chuangye-gu/graduation_project/pcb设计学习/工程/正.PNG

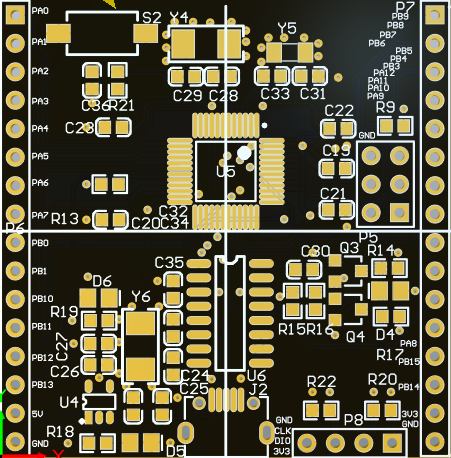
pcb设计学习/工程/正.PNG
