chuangye-gu/graduation_project/pcb设计学习/渲染PCB文件/渲染PCB文件/stm32正面.648.png

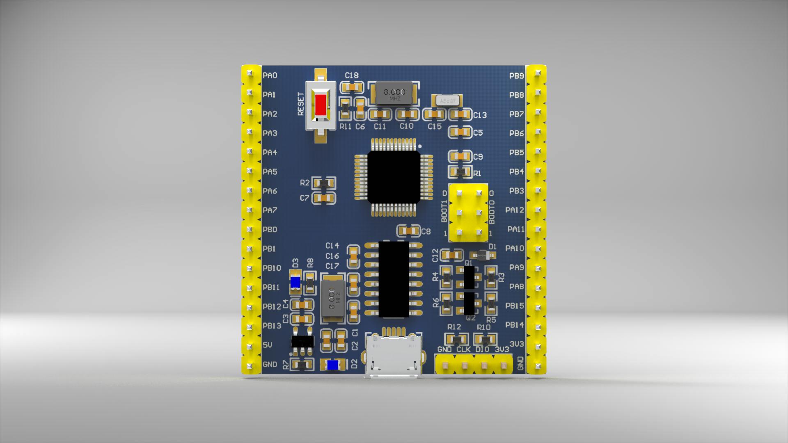
pcb设计学习/渲染PCB文件/渲染PCB文件/stm32正面.648.png
