chuangye-gu/graduation_project/pcb设计学习/元件库/元件库/AltiumDesignerIntlib-master/README.md

###知创学院[zicreate.com]原创Altium Designer集成库，我们会不断的整理完善更多的器件###
####下载地址：####
>**官网:**[http://zicreate.com/c/5640473a1aeee345906f5fa3][2]     [资料下载]
>**Github:**[https://github.com/zicreate/AltiumDesignerIntlib][1]
> 
  [1]: https://github.com/zicreate/AltiumDesignerIntlib
  [2]: http://zicreate.com/c/5640473a1aeee345906f5fa3
如果您在使用过程中发现有错误的地方，请及时告知我们，我们会及时勘误更新。
*本集成库由 zicreate.com jason 创作，采用知识共享署名3.0中国大陆许可协议进行许可。*

###Altium Designer Intlib V0.0.3###
####4.Digital IC####
```
     |---DAC8541              增加DAC8541DAC芯片
```
####2.Components####
```
     |---SIP3                 增加SIP3插座
```

###Altium Designer Intlib V0.0.2###
####1.Analog IC####
```
     |---L7805               增加贴片封装SOT-89-3
```
####4.Digital IC####
```
     |---MAX812              增加max812复位管理芯片
```

###Altium Designer Intlib V0.0.1###

####1.Analog IC####
```
    |---ADA4700-1           Operational Amplifier
    |---AMC1200
    |---AMS1117-3.3         3.3V  3-Terminal Adjustable Positive Voltage Regulator
    |---ATT7022
    |---DAC8551             DAC8551
    |---DAC8562
    |---L7805               3-Terminal Adjustable Positive Voltage Regulator
    |---LM2576
    |---MIC29302
    |---REF5025
    |---TPS63001            dc-dc
```
####2.Components####
```
    |---6N136               6N136
    |---BAT                 Multicell Battery
    |---BELL                Electrical Bell
    |---BRIDGE              Diode Bridge
    |---CAP1                Capacitor
    |---CAP2                Electrolytic Capacitor
    |---DIGITRON1*1         
    |---DIGITRON2*1
    |---DIGITRON3*1         
    |---DIGITRON4*1         
    |---DIODE               Diode
    |---DIODE1              Schottky Diode
    |---DSP2A               DSP2A
    |---FUSE-R              
    |---L                   Inductor
    |---LCD12864            
    |---LCD1602
    |---LED1                Typical RED GaAs LED
    |---LED2                LED,Two Colour,Common anode,Three Pin
    |---LED3                LED,Two Colour,Four Pin
    |---NMOS1               N-Channel Power MOSFET
    |---NMOS2               N-Channel Power MOSFET
    |---NPN                 NPN Transistor
    |---OPTOISO1            Optoisolator
    |---PNP                 PNP Transistor
    |---RELAYS              Single-Pole Dual-Throw Relay
    |---RELAYS1
    |---RES                 Resistance
    |---RES-P4
    |---RES-V
    |---Res Varistor        Varistor (Voltage-Sensitive Resistor)
    |---SW                  Switch
    |---SW-4                
    |---SW-8
    |---SW_CODED            Rotary Coded Switch
    |---TQ2                 
    |---TVS                 TVS
    |---TVS2                TVS
    |---XTAL                Crystal Oscillator
    |---XTAL_PW
    |---XTAL_PWR
    |---ZENER               Zener Diode
```
####3.Connectors####
```
   |---CON10
   |---CON13
   |---CON2
   |---CON3
   |---CON4
   |---CON5
   |---CON6
   |---CON8                
   |---DB9RA
   |---DIN64
   |---DIN96               
   |---HARTING-F-48        HARTING-F-48
   |---HR911105A
   |---HR911105A_1         
   |---Header10X2          Header10X2
   |---Header15X2          Header15X2
   |---Header3X2           Header3X2
   |---Header5X2           Header5X2
   |---Header8X2           Header10X2
   |---MINIUSB             
   |---PWR2.5              Low Voltage Power Supply Connector
   |---RJ45                
   |---TP
```
####4.Digital IC####
```
   |---74HC14              74HC14
   |---74HC573             74HC573
   |---AT24C16
   |---AT45DB041D          Flash IC
   |---BL55076             
   |---CAN                 CAN 5V
   |---DAC2904             DAC2904
   |---DM9161AE            Ethernet PHY
   |---DP83848I            Ethernet PHY
   |---DS1302N             Trickle Charge Timekeeping Chip
   |---DS2460
   |---FRAM                FRAM FM25L64
   |---PCF8575             PCF8575
   |---PCF8583             RTC
   |---RS232               RS232 IC 3.3V
   |---RS485               RS485 IC 3.3V
   |---TPS3823-33
   |---ULN2003A
   |---ULN2803A
```
####5.Microcontrollers####
```
   |---LPC1758FBD80        ARM Cortex M3,LQFP80 Footprint
   |---LPC1768FBD100       ARM Cortex M3,LQFP100 Footprint
   |---LPC2138FBD64
   |---LPC2468
   |---STC12C5A32S2
   |---STC89C52RC          80C51 8-Bit Flash Microcontroller Family, 8 kB Flash
   |---STM32F103ZET6
```
####6.Module####
```
   |---B0505LS             
   |---CTM1050T
   |---EMW3162             EMW3162
   |---LPC1768-M           LPC1758 Module
   |---ZY_WHAD-10W
```
