chuangye-gu/graduation_project/毕业答辩PPT模版.pptx

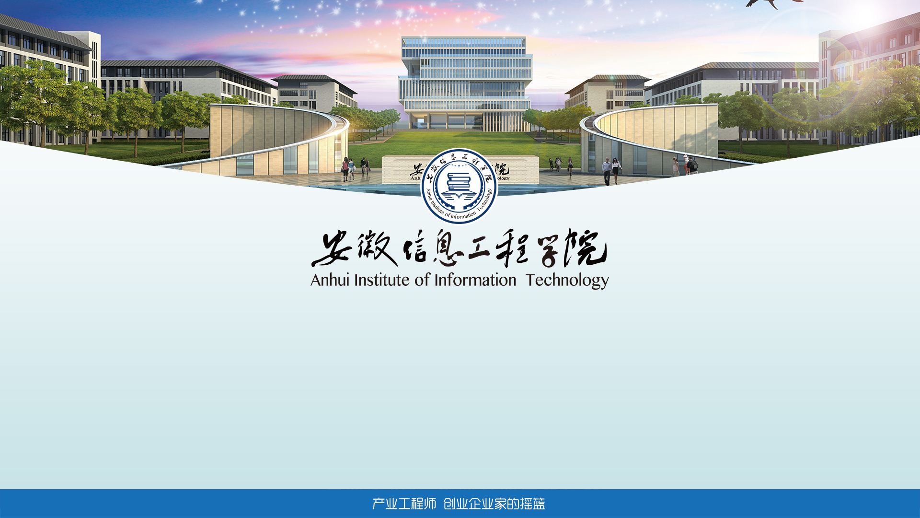
[picture p3: figure]

论文题目

汇报人：***
日期：2020年5月24日

## Slide 2

目 录

Part 1

研究背景、意义及目标

研究内容及设计方案

Part 2

Part 2

研究结果、总结

## Slide 3

研究背景、意义及目标

该部分简单介绍，一带而过。

## Slide 4

研究内容及设计方案

详细介绍设计方案。

## Slide 5

研究结果、总结

研究结果（做出实物的写实物调试结果，没有实物的同学写仿真结果）、不足之处。

## Slide 6
