chuangye-gu/graduation_project/归档打印/3.1-彩色打印修改.pdf

谷创业：恒温烤箱系统的设计

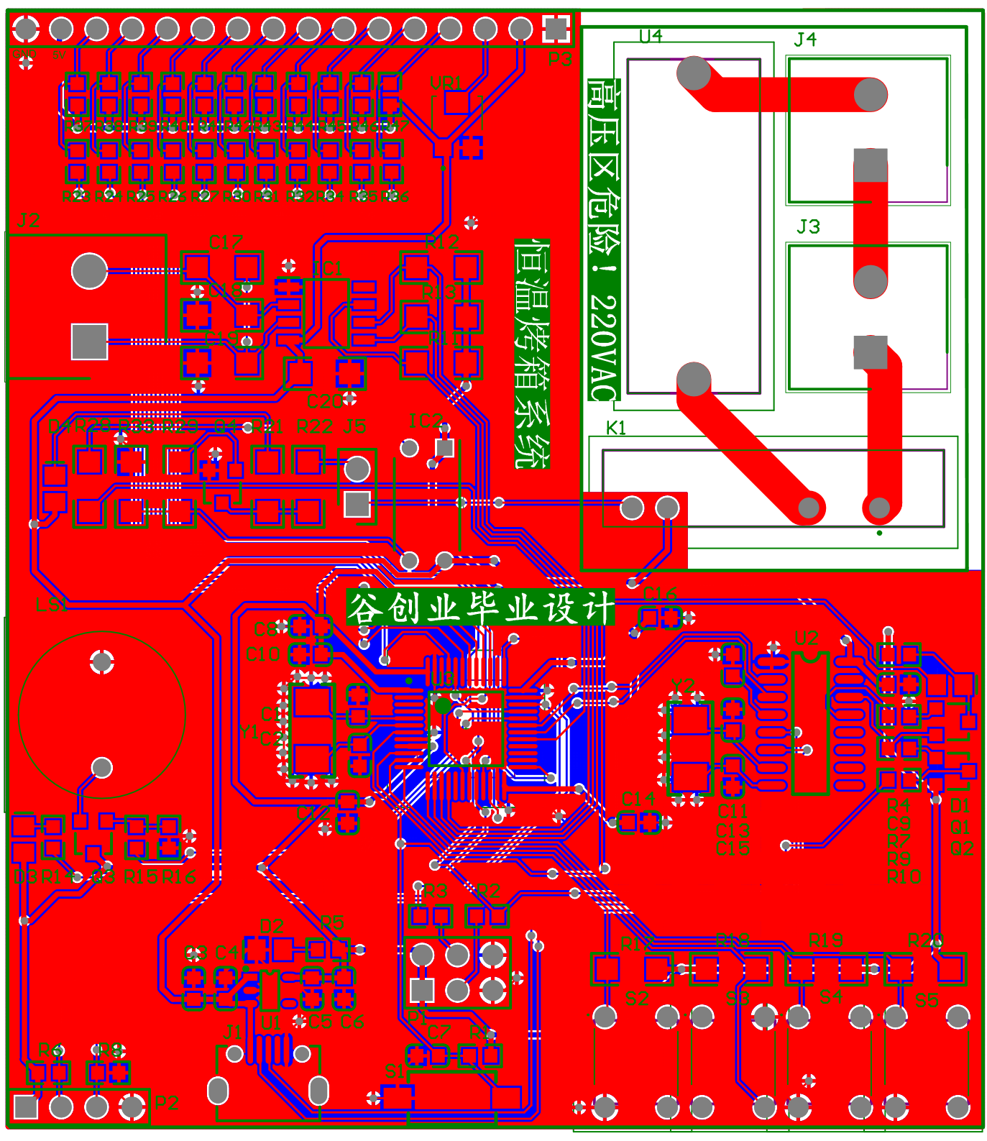
[picture p4: figure]

- 38 -

## 附录 B PCB
