chuangye-gu/graduation_project/归档文件/谷创业-档案袋封面.docx

2020届本科毕业设计（论文）

题目 | | 恒温烤箱系统的设计
学生姓名 | | 谷创业 | | | 学号 | | 316207010104
学院 | | 电气与电子工程学院 | | | 专业班级 | | 自动化1601班
指导教师 | | 张松林 | | | 完成日期 | | 2020年05月26日

装袋材料清单（按照序号从上到下装袋）
序号 | 材料名称 | | 数量 | 序号 | | 材料名称 | | 数量
1 | 诚信承诺书 | | 1份 | 6 | | 指导记录 | | 1份
2 | 成绩评定表 | | 1份 | 7 | | 中期检查表 | | 1份
3 | 论文定稿 | | 1份 | 8 | | 答辩记录表 | | 1份
4 | 任务书 | | 1份 | 9 | | 相似性检测报告 | | 1份
5 | 开题报告 | | 1份 | 10 | | 图纸及其他 | | 1份

教务处 制
