chuangye-gu/graduation_project/归档文件/word/1-谷创业-诚信承诺书.docx

本科毕业设计（论文）诚信承诺书

1.本人郑重地承诺所呈交的毕业设计（论文），是在指导教师的指导下严格按照学校和学院有关规定完成的。

2.本人在毕业设计（论文）中引用他人的观点和参考的资料均加以了注释和说明。

3.本人承诺在毕业设计（论文）选题和研究内容过程中没有抄袭他人研究成果和伪造相关数据等行为。

4.本人在毕业设计（论文）中对侵犯任何方面知识产权的行为，将由本人承担一切相应的法律责任。

作者签名： 谷创业

2019年11月4日
