chuangye-gu/graduation_project/1602/1.PNG

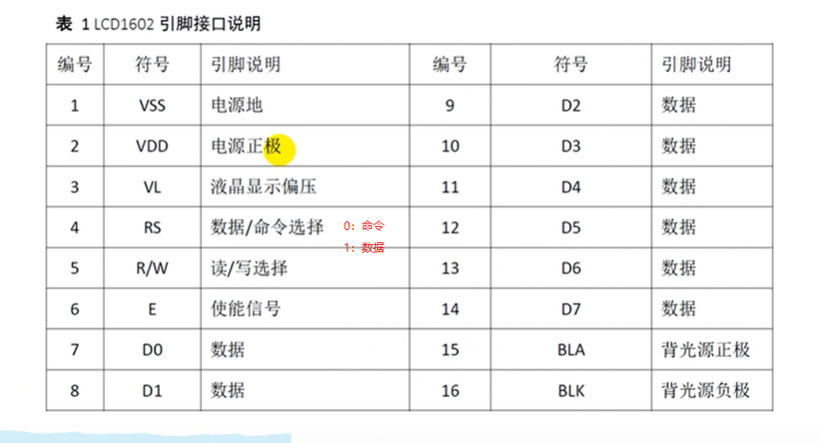
1602/1.PNG
