chuangye-gu/graduation_project/1602/2.PNG

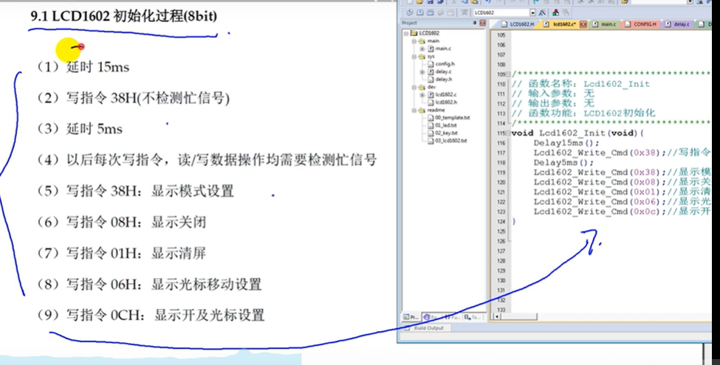
1602/2.PNG
