chuangye-gu/graduation_project/1602/3.PNG

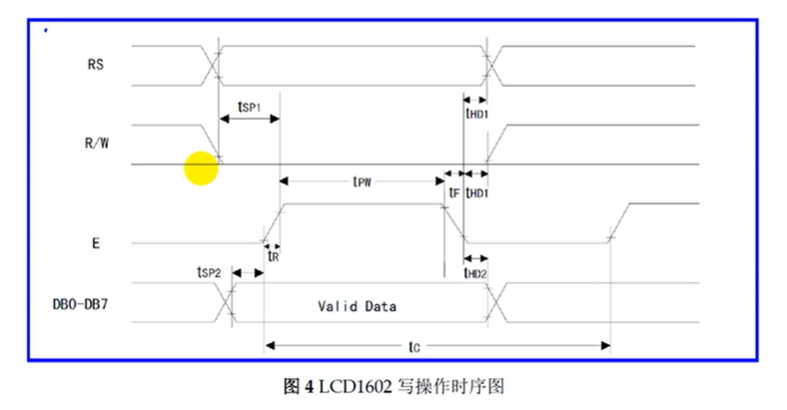
1602/3.PNG
