chuangye-gu/graduation_project/1602/4.PNG

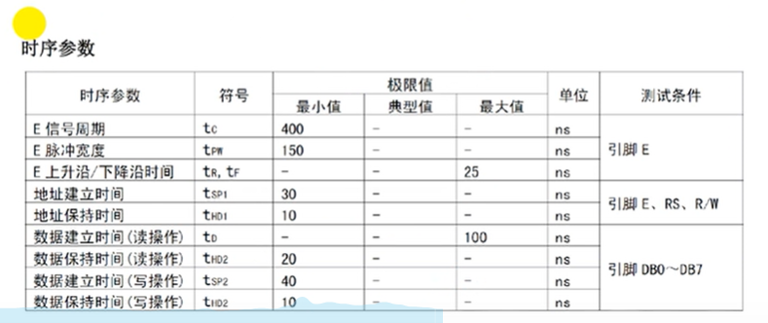
1602/4.PNG
