chuangye-gu/graduation_project/PCB/yunqijian/1.PNG

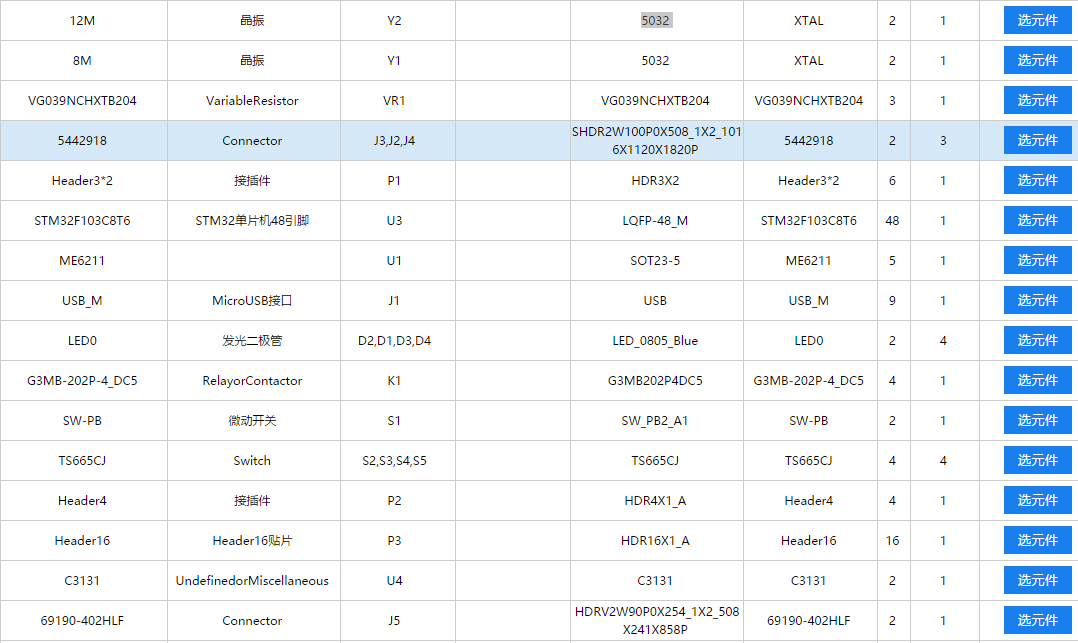
PCB/yunqijian/1.PNG
