chuangye-gu/graduation_project/PCB/恒温烤箱控制系统/正面.PNG

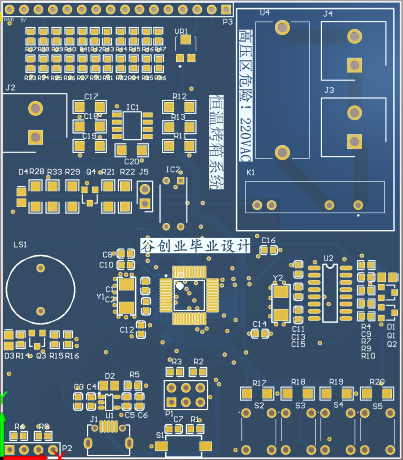
PCB/恒温烤箱控制系统/正面.PNG
