chuangye-gu/graduation_project/pcb设计学习/工程/反.PNG

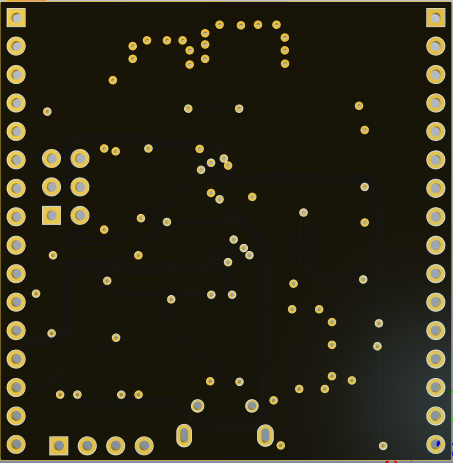
pcb设计学习/工程/反.PNG
