chuangye-gu/graduation_project/pcb设计学习/渲染PCB文件/渲染PCB文件/1WY$}5K@$B`TE4E2D@VDA6P.png

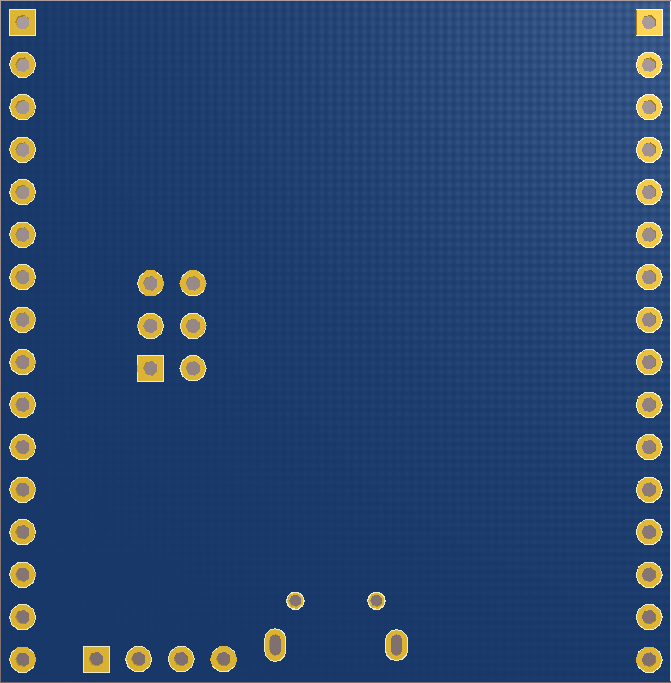
pcb设计学习/渲染PCB文件/渲染PCB文件/1WY$}5K@$B`TE4E2D@VDA6P.png
