chuangye-gu/graduation_project/pcb设计学习/渲染PCB文件/渲染PCB文件/4JOJ[C2_WN(F_FNJ7RSONUU.png

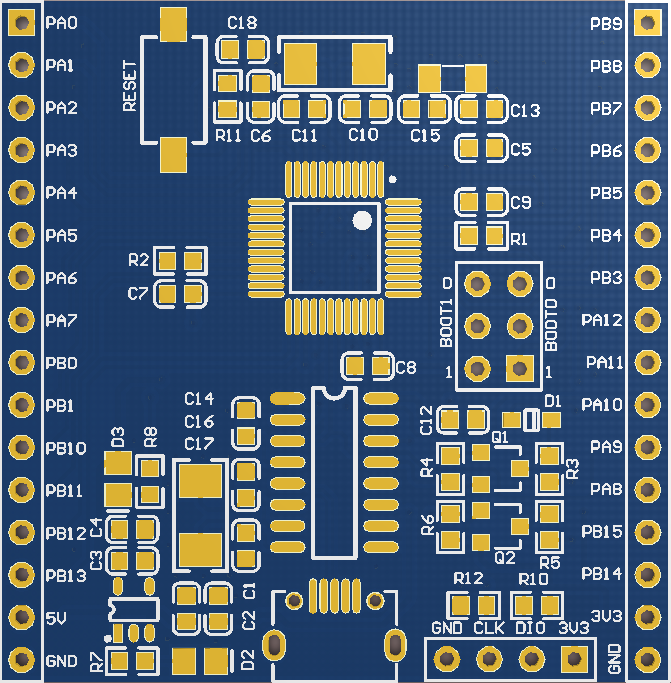
pcb设计学习/渲染PCB文件/渲染PCB文件/4JOJ[C2_WN(F_FNJ7RSONUU.png
