chuangye-gu/graduation_project/图片/1-1Q22920215I55.png

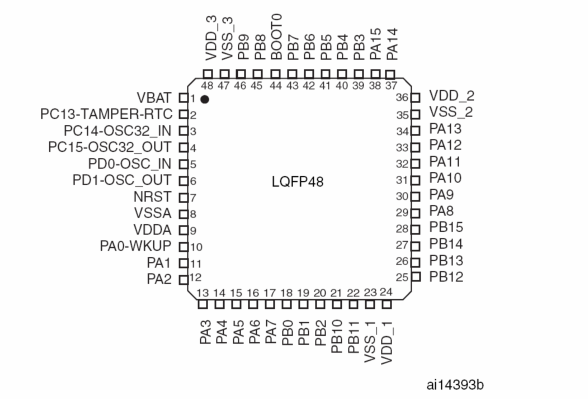
图片/1-1Q22920215I55.png
