chuangye-gu/graduation_project/图片/50摄氏度.png

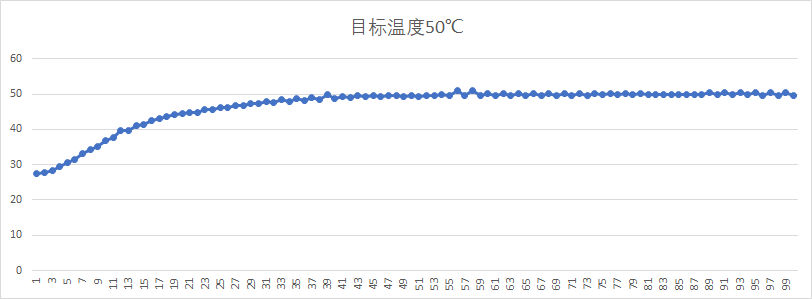
图片/50摄氏度.png
