chuangye-gu/graduation_project/图片/70摄氏度.png

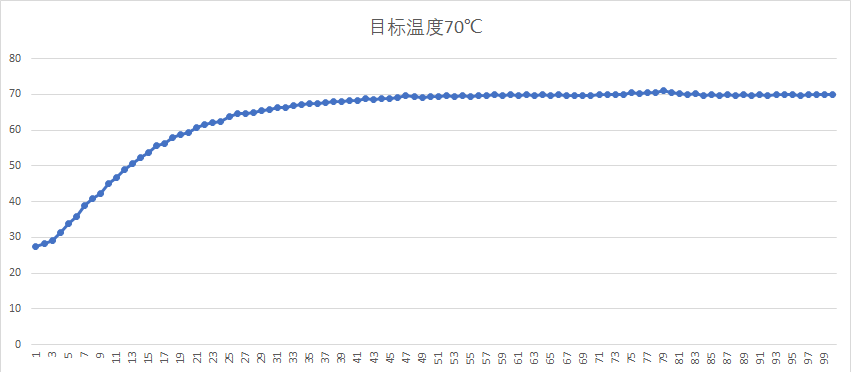
图片/70摄氏度.png
