chuangye-gu/graduation_project/图片/boot.PNG

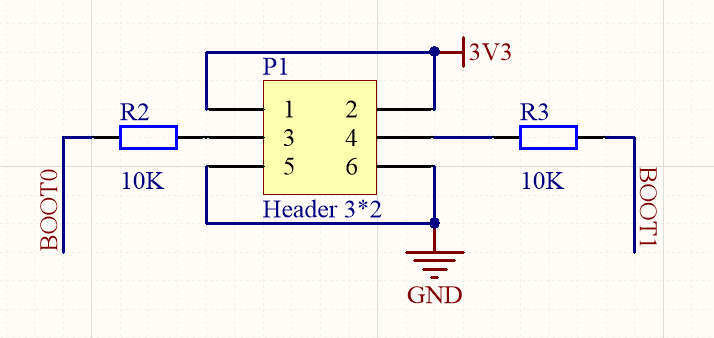
图片/boot.PNG
