chuangye-gu/graduation_project/图片/c8t6引脚.png

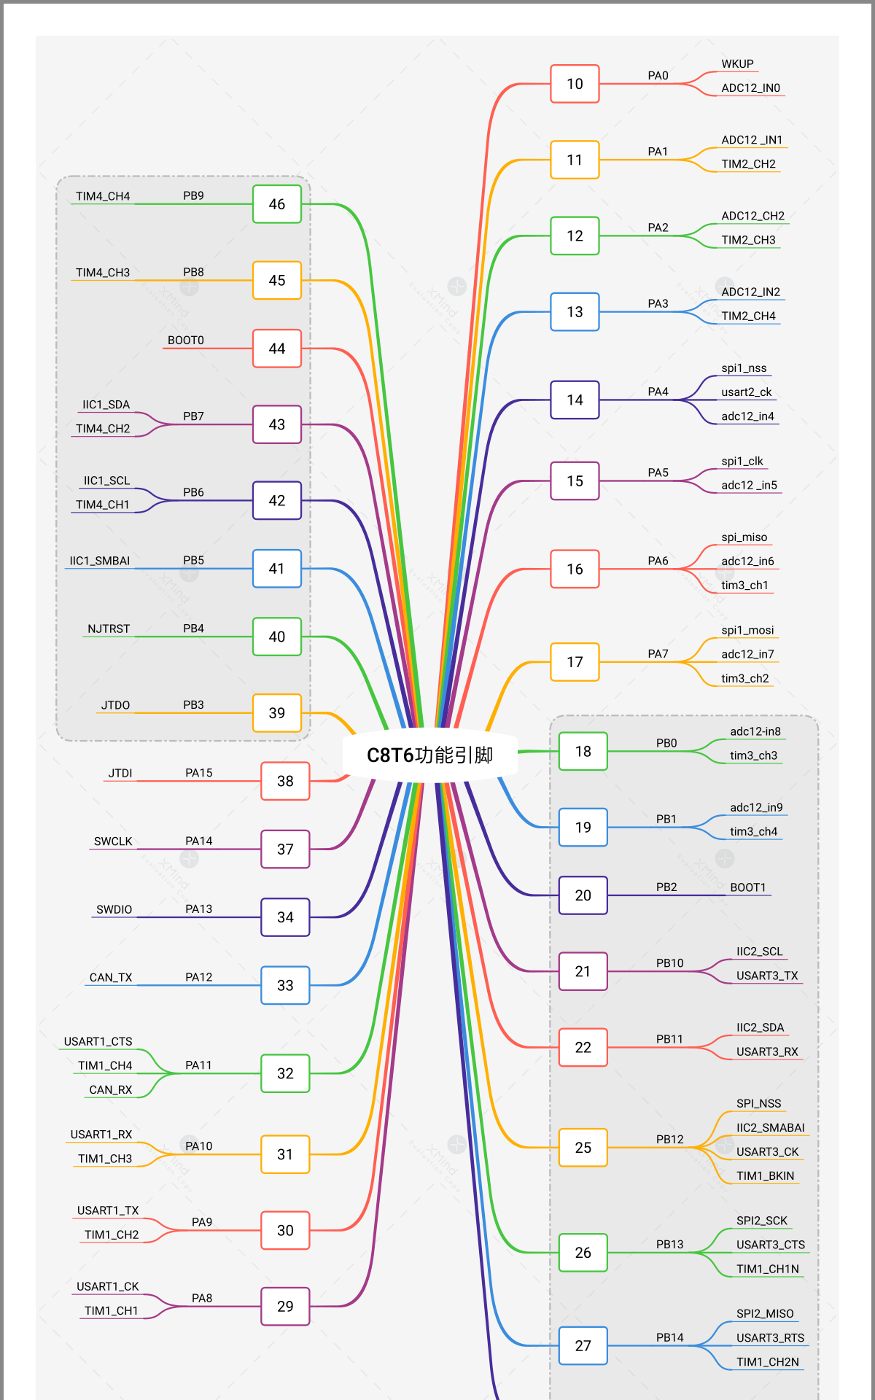
图片/c8t6引脚.png
