chuangye-gu/graduation_project/图片/CH340.PNG

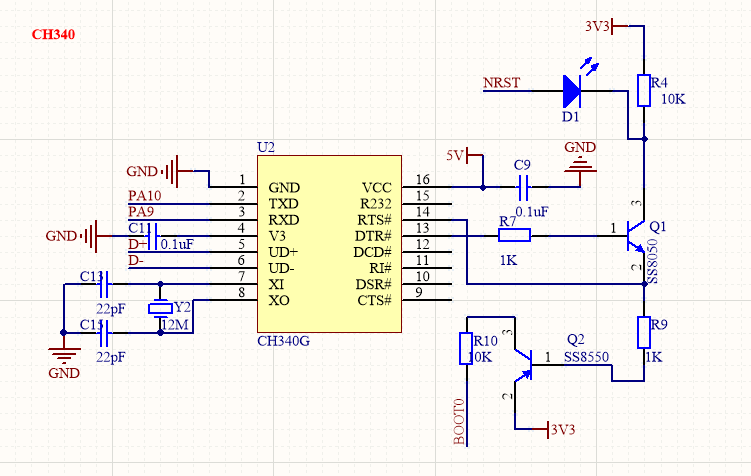
图片/CH340.PNG
