chuangye-gu/graduation_project/图片/lcd.PNG

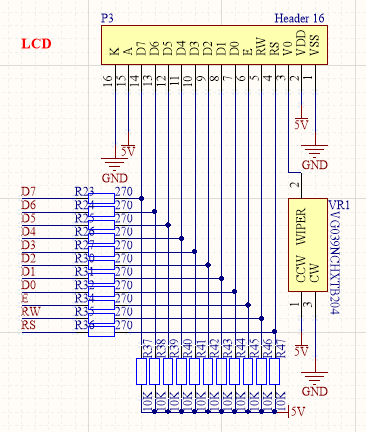
图片/lcd.PNG
