chuangye-gu/graduation_project/图片/MAX6675时序图.PNG

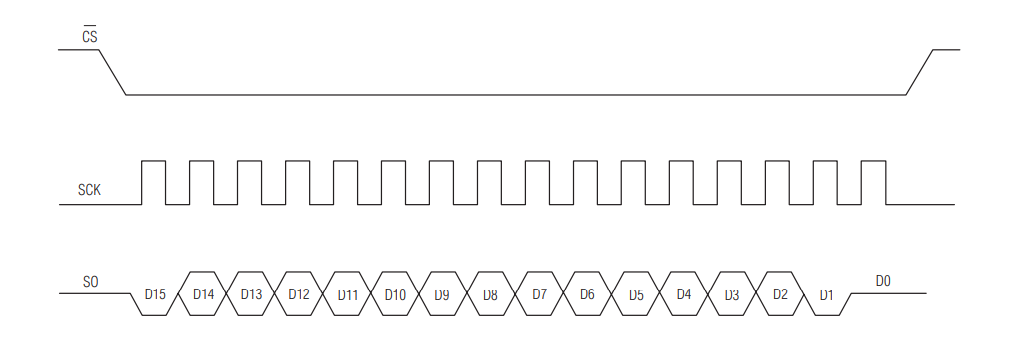
图片/MAX6675时序图.PNG
