chuangye-gu/graduation_project/图片/PID控制算法流程图.png

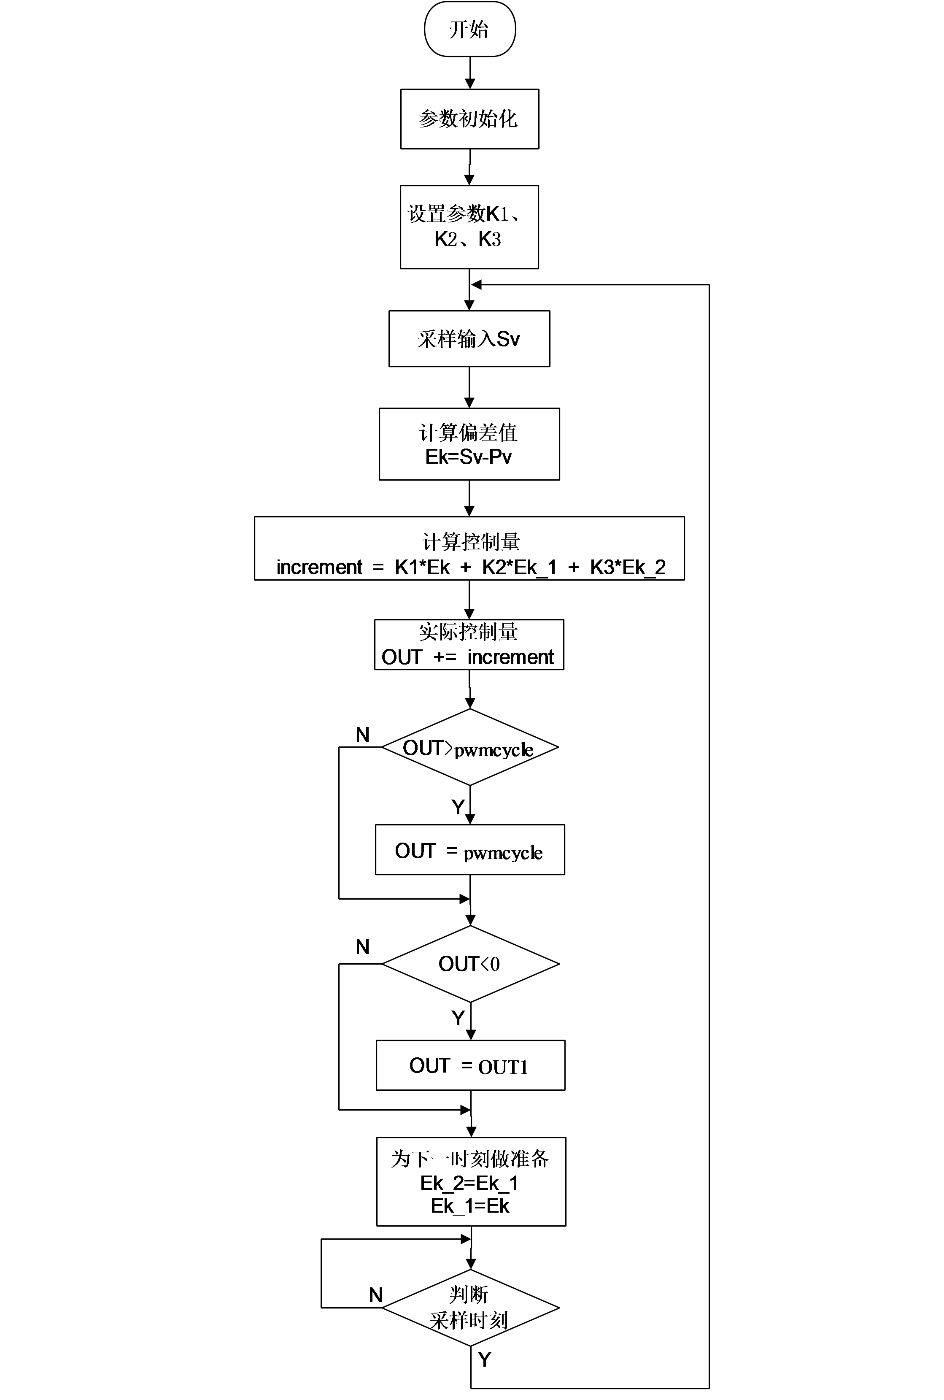
图片/PID控制算法流程图.png
