chuangye-gu/graduation_project/图片/下载.PNG

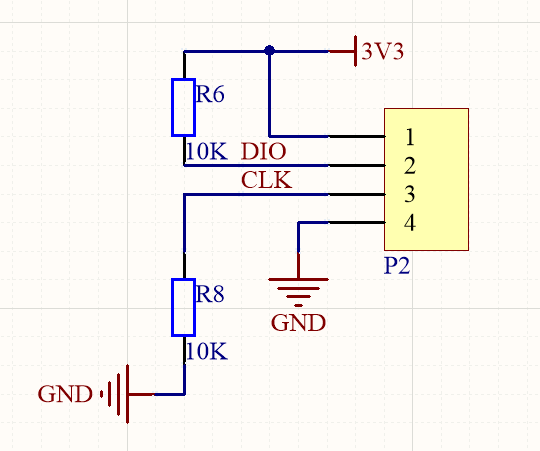
图片/下载.PNG
