chuangye-gu/graduation_project/图片/主程序.jpg

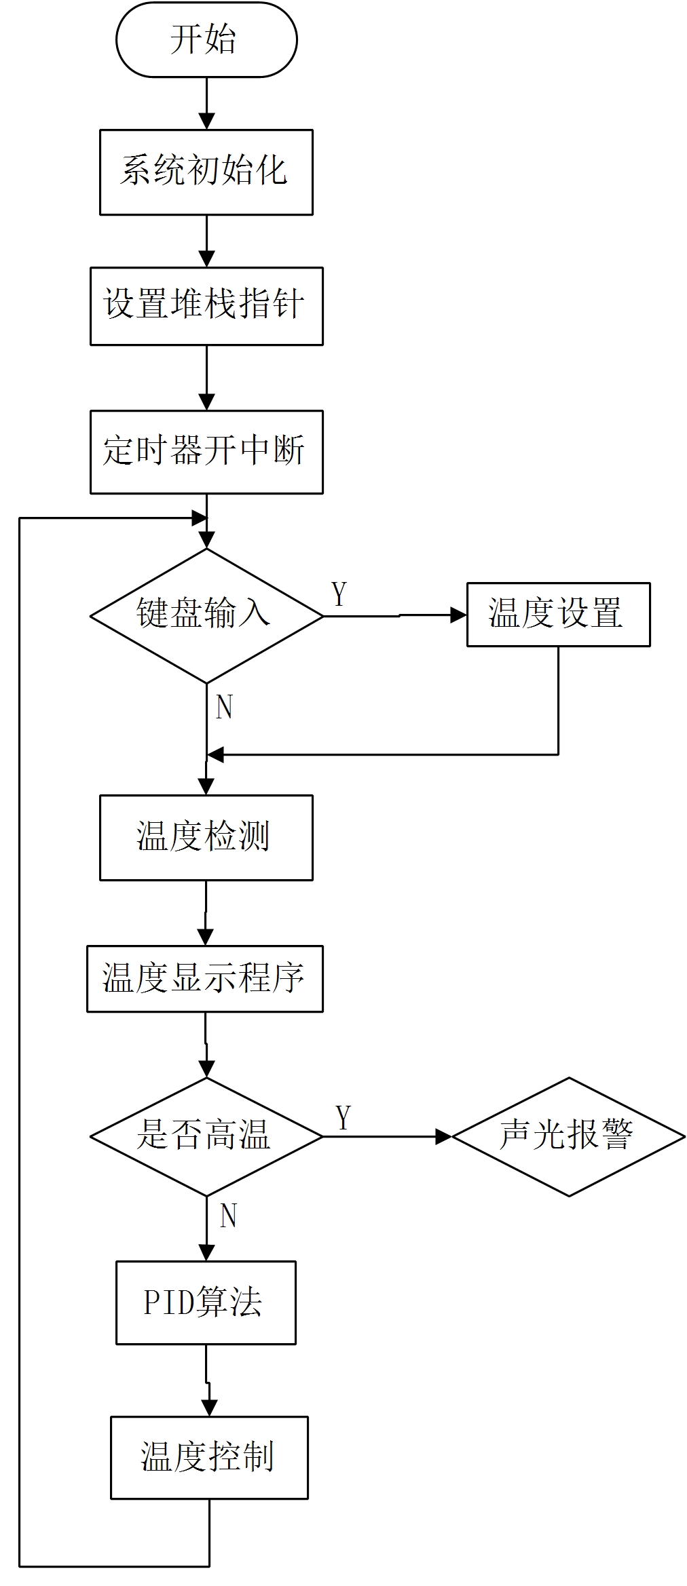
图片/主程序.jpg
