chuangye-gu/graduation_project/图片/主程序.png

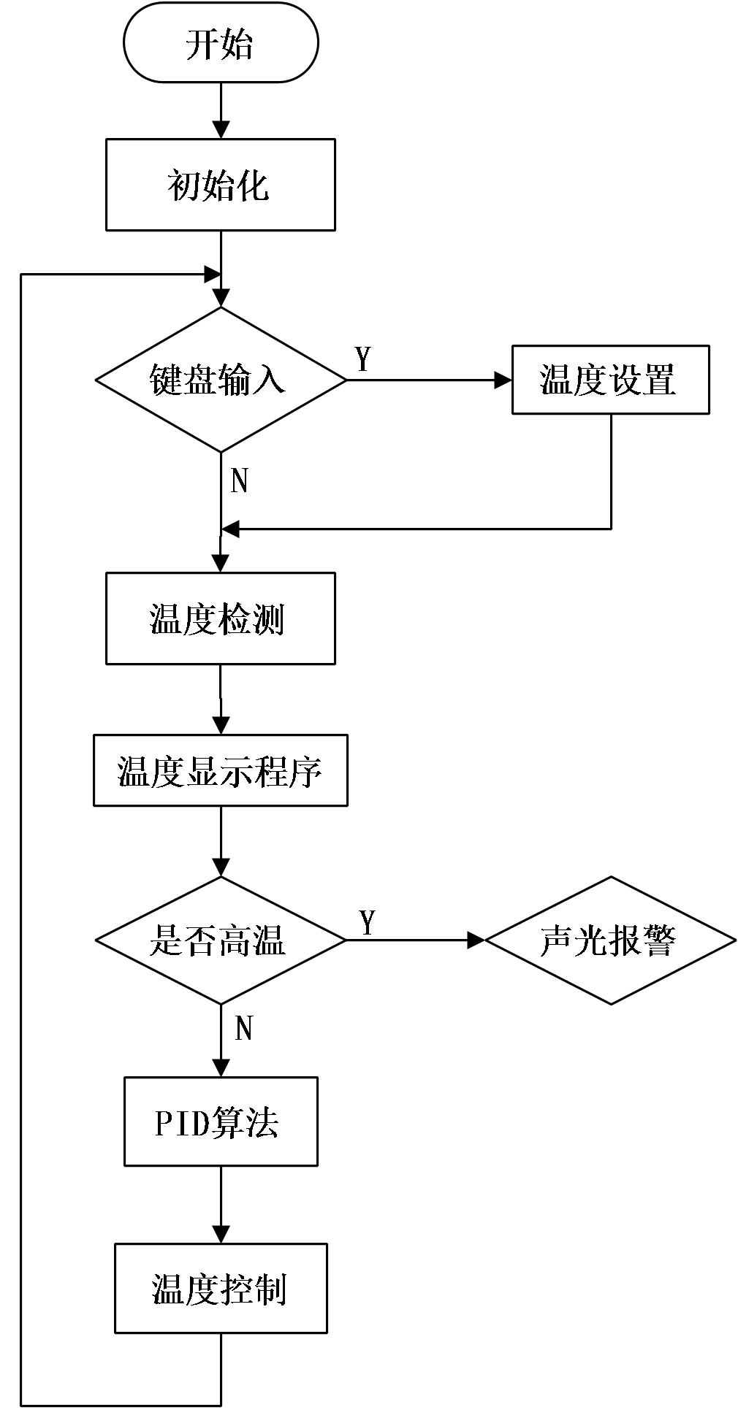
图片/主程序.png
