chuangye-gu/graduation_project/图片/仿真主图.PNG

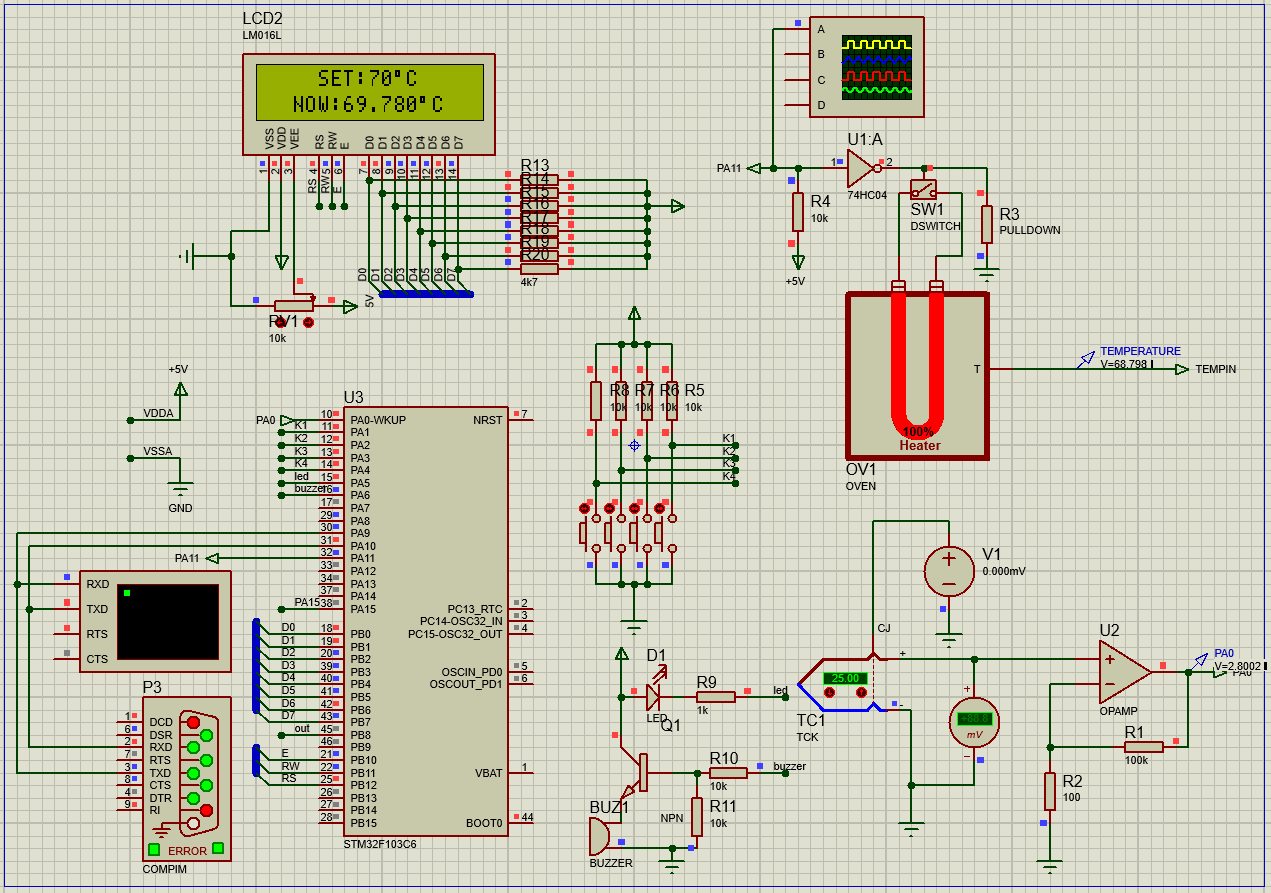
图片/仿真主图.PNG
