chuangye-gu/graduation_project/图片/仿真副图.PNG

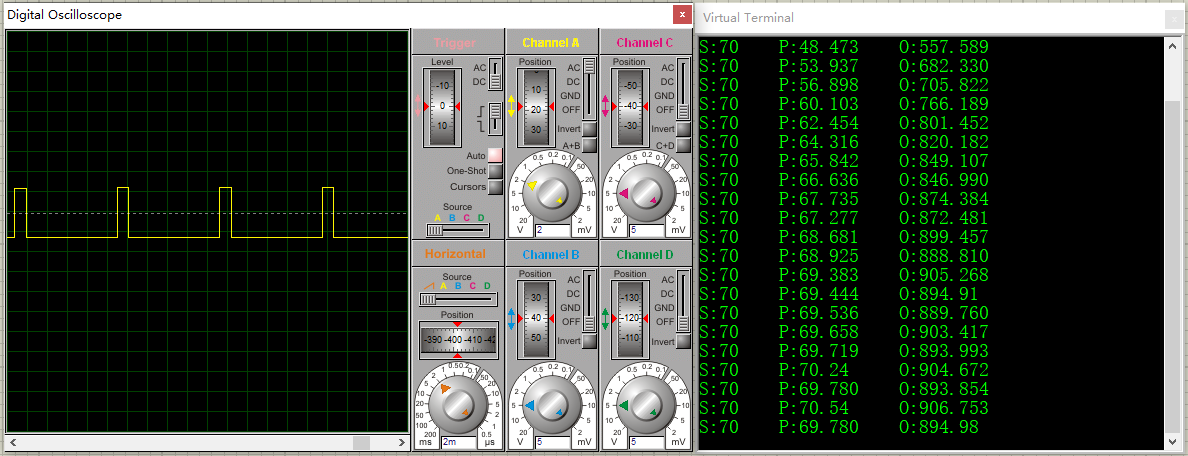
图片/仿真副图.PNG
