chuangye-gu/graduation_project/图片/仿真图.png

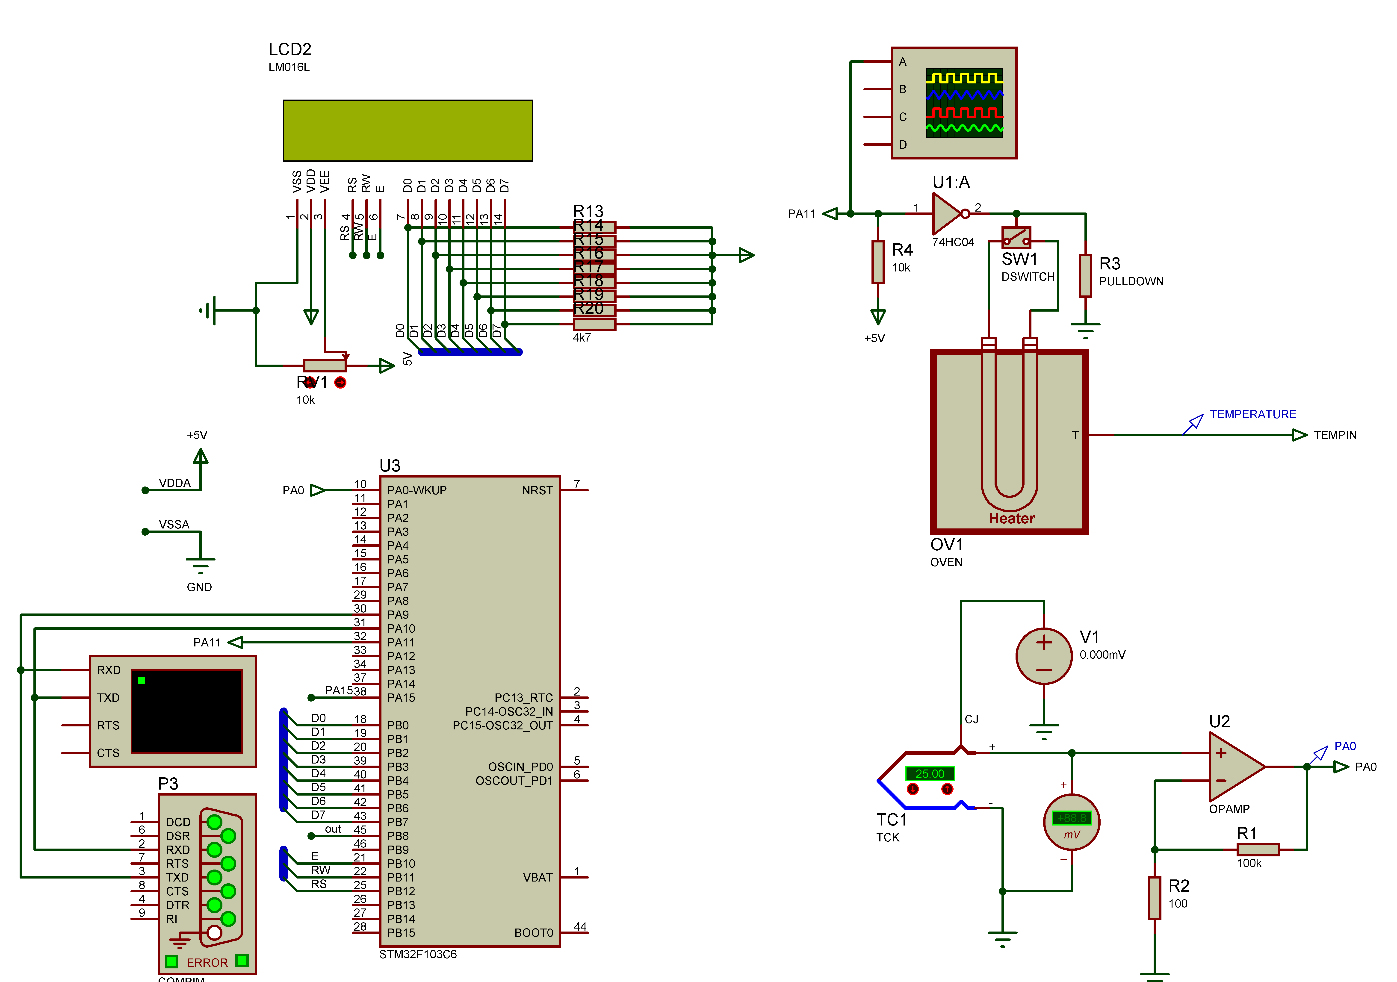
图片/仿真图.png
