chuangye-gu/graduation_project/图片/仿真部分文字.PNG

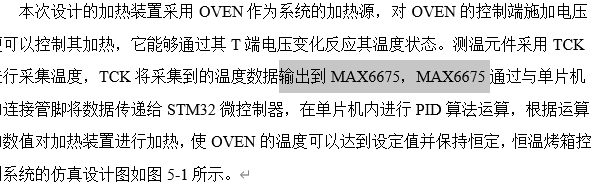
图片/仿真部分文字.PNG
