chuangye-gu/graduation_project/图片/报警.PNG

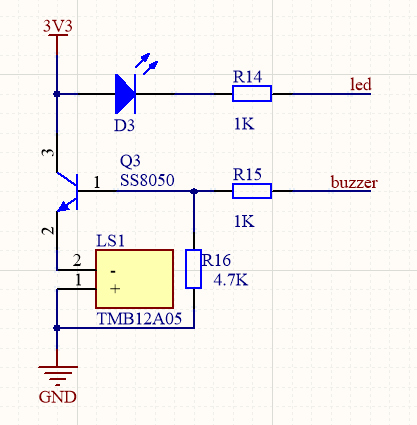
图片/报警.PNG
