chuangye-gu/graduation_project/图片/控制电路.PNG

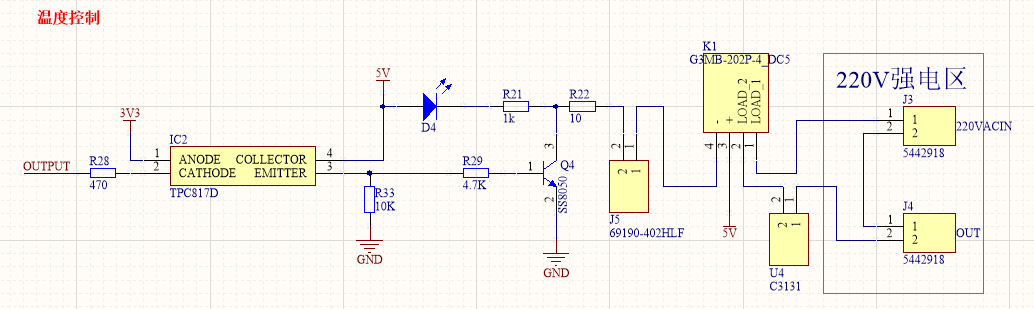
图片/控制电路.PNG
