chuangye-gu/graduation_project/图片/显示程序.png

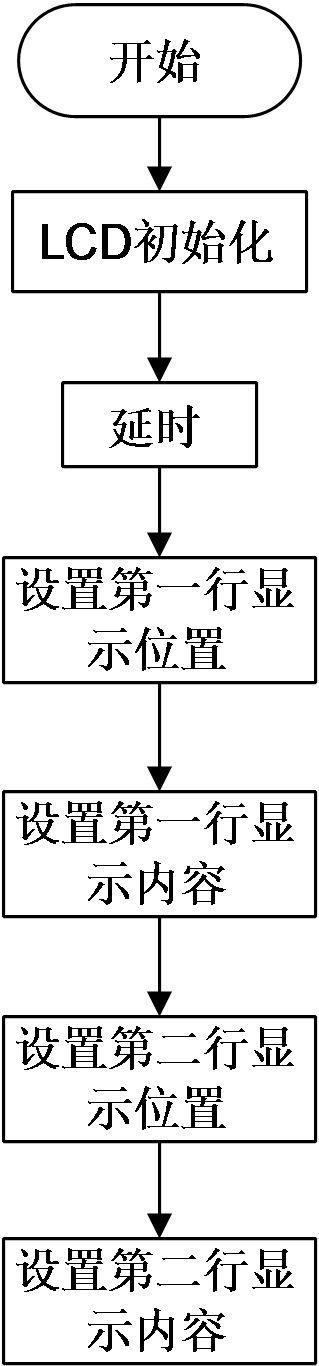
图片/显示程序.png
