chuangye-gu/graduation_project/图片/温度控制.png

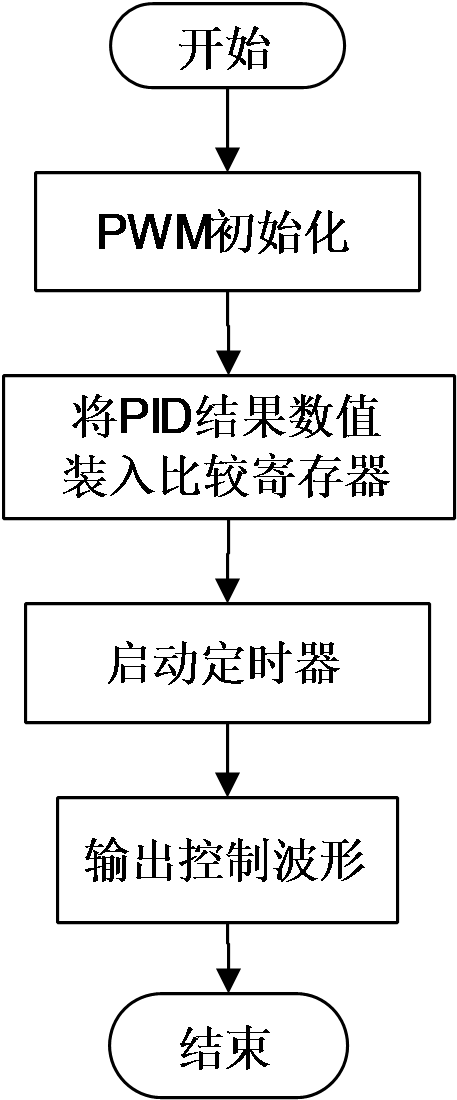
图片/温度控制.png
