chuangye-gu/graduation_project/图片/温度检测.png

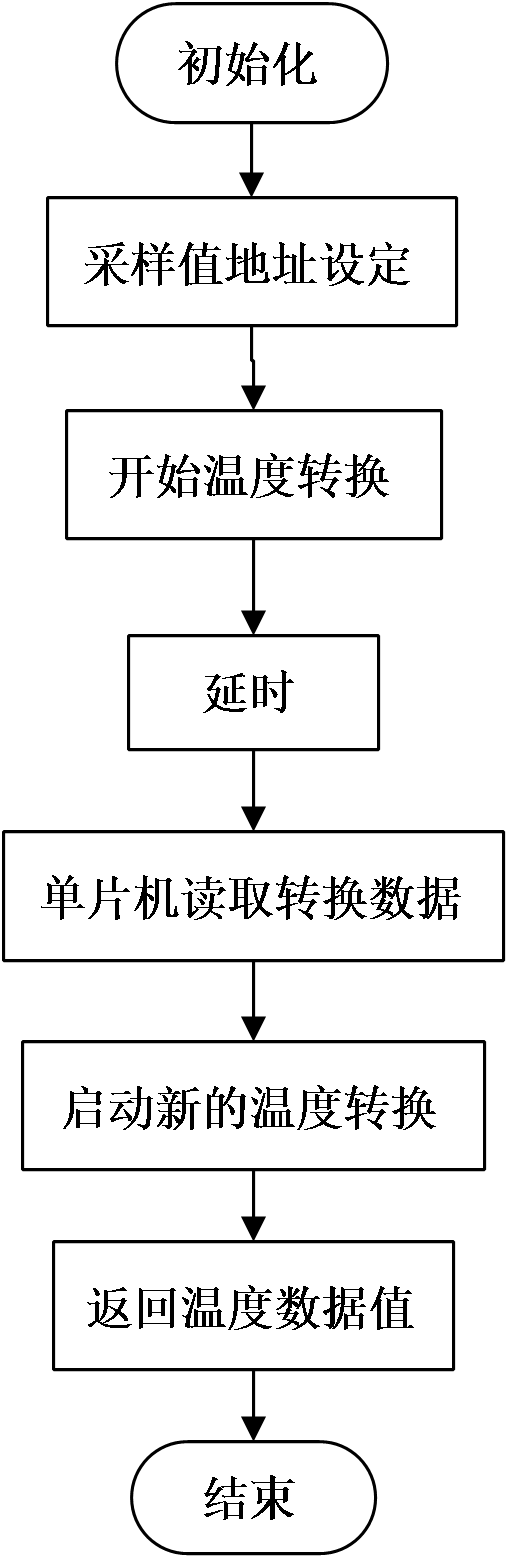
图片/温度检测.png
