chuangye-gu/graduation_project/图片/温度采集.PNG

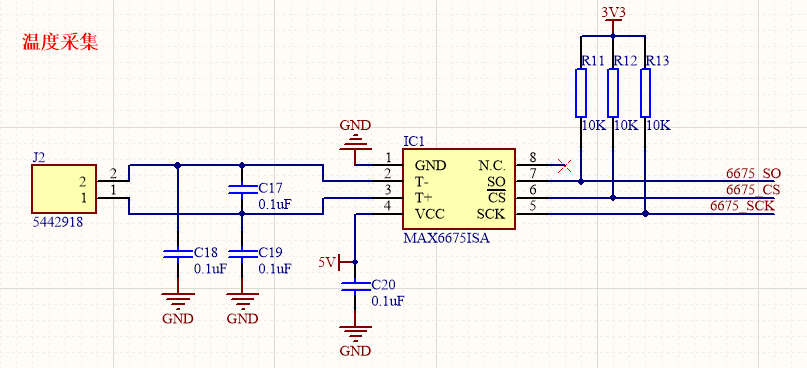
图片/温度采集.PNG
