chuangye-gu/graduation_project/图片/电源.PNG

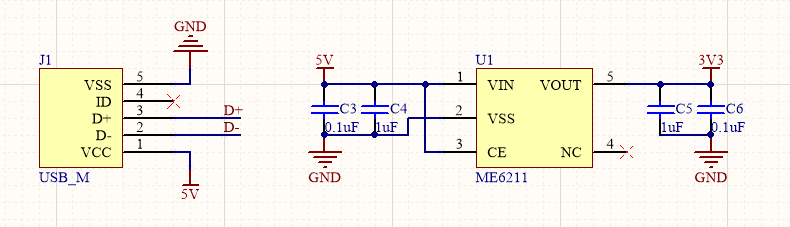
图片/电源.PNG
