chuangye-gu/graduation_project/图片/硬件框图.png

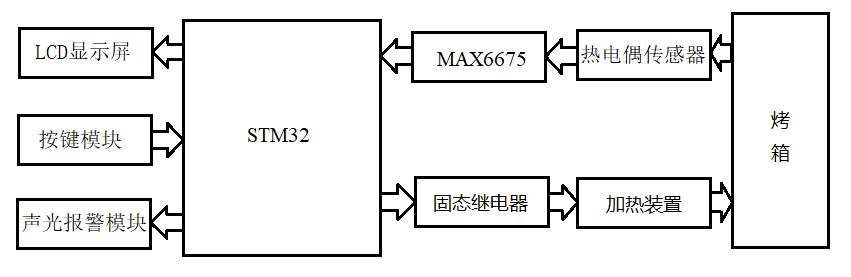
图片/硬件框图.png
