chuangye-gu/graduation_project/pcb设计学习/元件库/元件库/PCB3D/User Library-jingzhentp.STEP

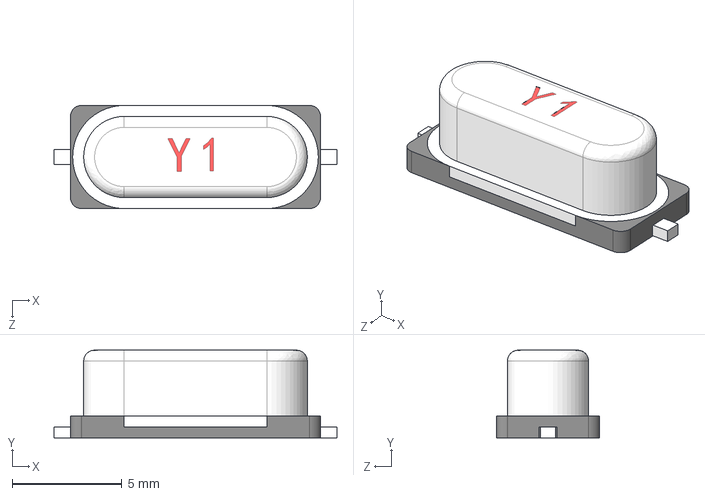
[picture p68: CAD file, 2020-04-28]
pcb设计学习/元件库/元件库/PCB3D/User Library-jingzhentp.STEP
12.9 x 4.00 x 4.70 mm
