chuangye-gu/graduation_project/pcb设计学习/元件库/元件库/PCB3D/User Library-LQFP48_Grid_0_5.STEP

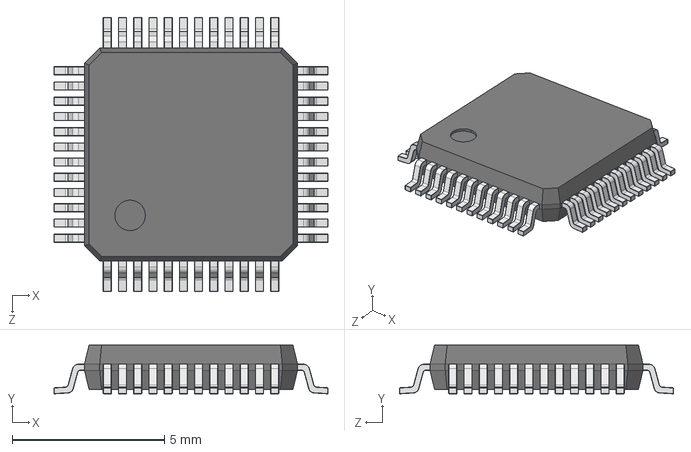
[picture p69: CAD file, 2020-04-28]
pcb设计学习/元件库/元件库/PCB3D/User Library-LQFP48_Grid_0_5.STEP
9.00 x 1.60 x 9.00 mm
LQFP48_Koerper_2
LQFP_PIN_2 x 48
