chuangye-gu/graduation_project/pcb设计学习/元件库/元件库/PCB3D/User Library-SOP16_208mil (5_3mm).STEP

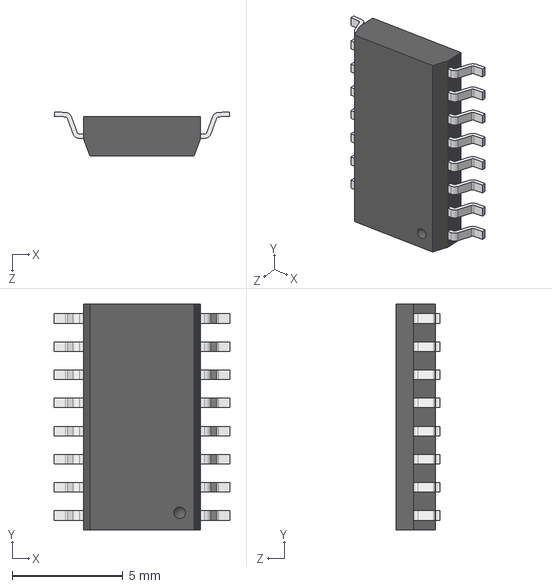
[picture p70: CAD file, 2020-04-28]
pcb设计学习/元件库/元件库/PCB3D/User Library-SOP16_208mil (5_3mm).STEP
7.92 x 10.2 x 2.00 mm
SOP16 Body
Foot SOP16 x 28
