chuangye-gu/graduation_project/pcb设计学习/元件库/元件库/PCB3D/User Library-ADXL345.STEP

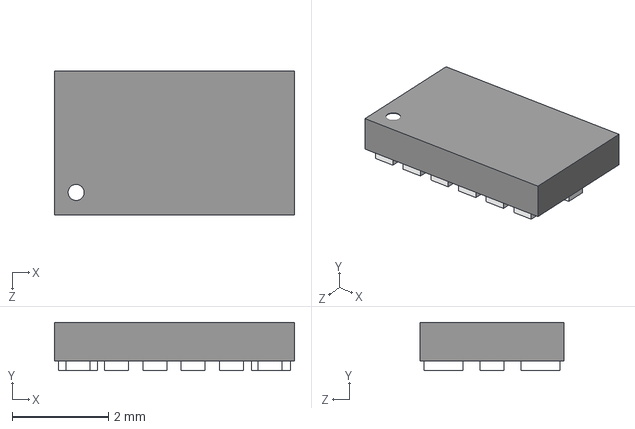
[picture p71: CAD file, 2020-04-28]
pcb设计学习/元件库/元件库/PCB3D/User Library-ADXL345.STEP
5.00 x 1.00 x 3.00 mm
