chuangye-gu/graduation_project/pcb设计学习/元件库/元件库/PCB3D/User Library-LQFP48-2.STEP

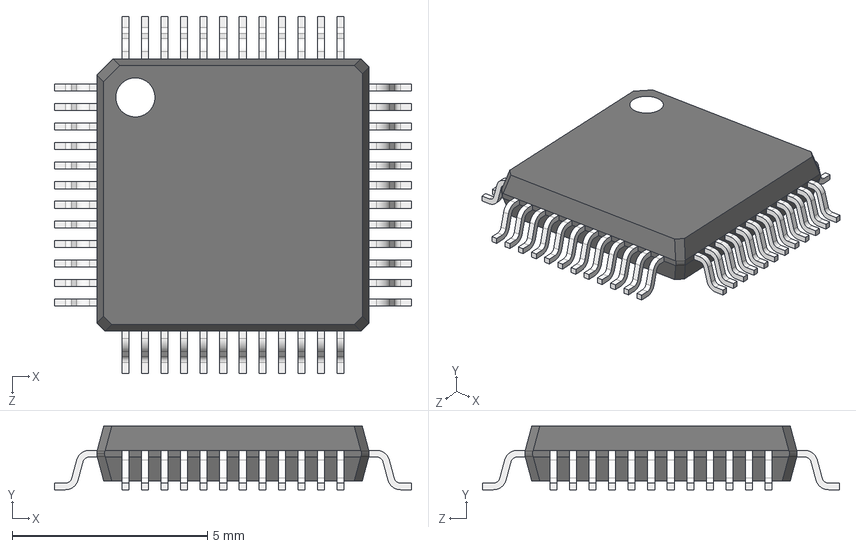
[picture p72: CAD file, 2020-04-28]
pcb设计学习/元件库/元件库/PCB3D/User Library-LQFP48-2.STEP
9.14 x 1.63 x 9.14 mm
case
pin x 48
circle
