chuangye-gu/graduation_project/pcb设计学习/元件库/元件库/PCB3D/User Library-jingzhen.STEP

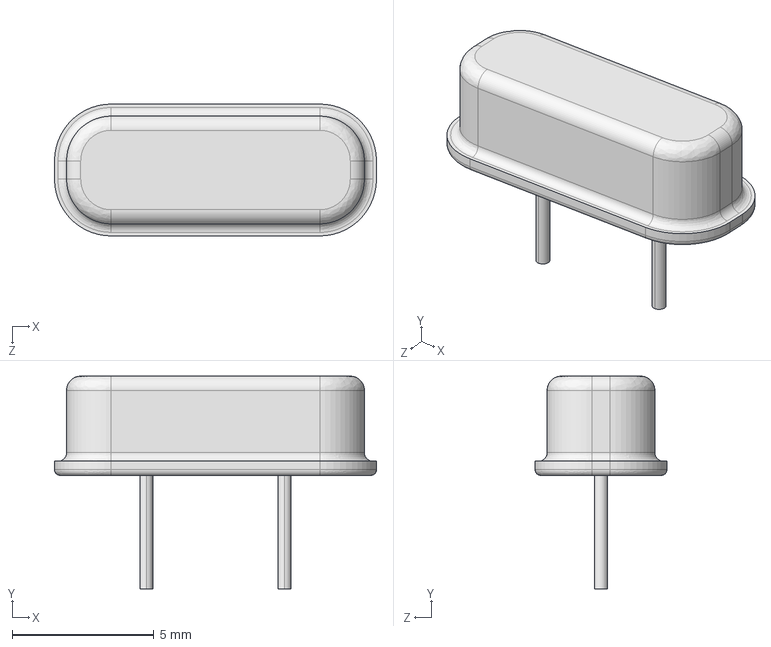
[picture p73: CAD file, 2020-04-28]
pcb设计学习/元件库/元件库/PCB3D/User Library-jingzhen.STEP
11.4 x 7.50 x 4.65 mm
