chuangye-gu/graduation_project/pcb设计学习/元件库/元件库/PCB3D/CircuitWorks-LED 1206.STEP

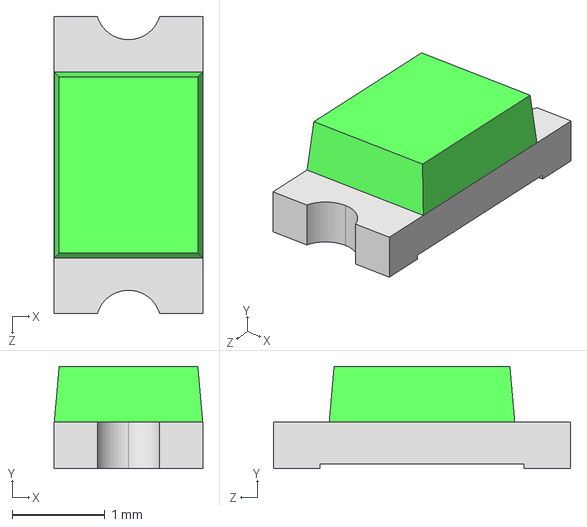
[picture p74: CAD file, 2020-04-28]
pcb设计学习/元件库/元件库/PCB3D/CircuitWorks-LED 1206.STEP
1.60 x 1.10 x 3.20 mm
