chuangye-gu/graduation_project/pcb设计学习/元件库/元件库/PCB3D/User Library-SOIC-16-1.STEP

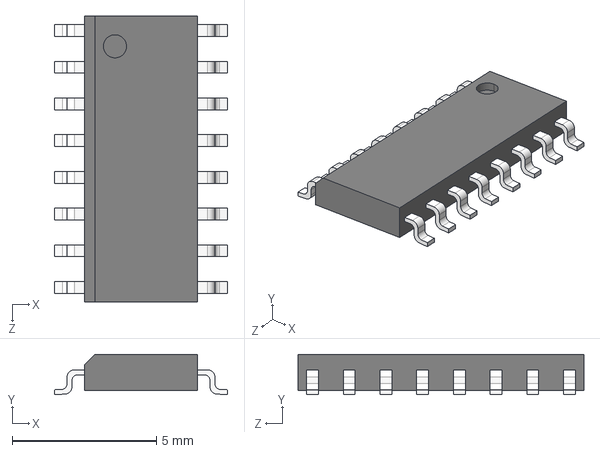
[picture p75: CAD file, 2020-04-28]
pcb设计学习/元件库/元件库/PCB3D/User Library-SOIC-16-1.STEP
6.00 x 1.40 x 9.90 mm
