chuangye-gu/graduation_project/pcb设计学习/元件库/元件库/PCB3D/CircuitWorks-SOT-23.STEP

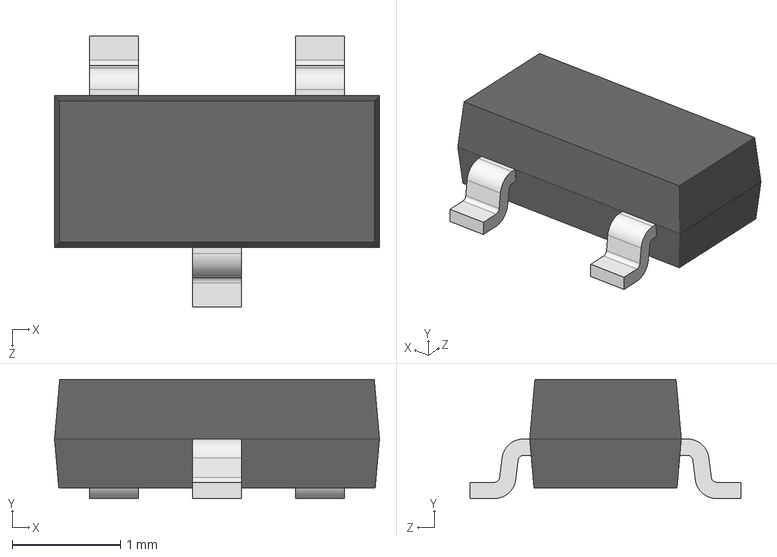
[picture p76: CAD file, 2020-04-28]
pcb设计学习/元件库/元件库/PCB3D/CircuitWorks-SOT-23.STEP
3.00 x 1.10 x 2.50 mm
