chuangye-gu/graduation_project/pcb设计学习/元件库/元件库/PCB3D/User Library-WIFI - ESP8266M0D.STEP

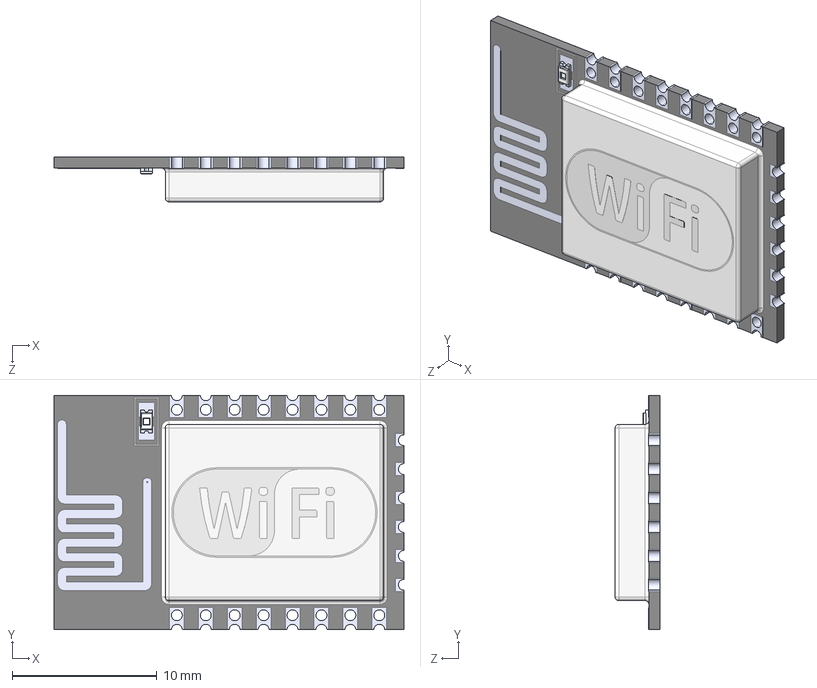
[picture p77: CAD file, 2020-04-28]
pcb设计学习/元件库/元件库/PCB3D/User Library-WIFI - ESP8266M0D.STEP
24.2 x 16.2 x 3.13 mm
WIFI
LED
PLACA_LED
