chuangye-gu/graduation_project/pcb设计学习/元件库/元件库/PCB3D/everlight-17-21-0805LED-YELLOW.STEP

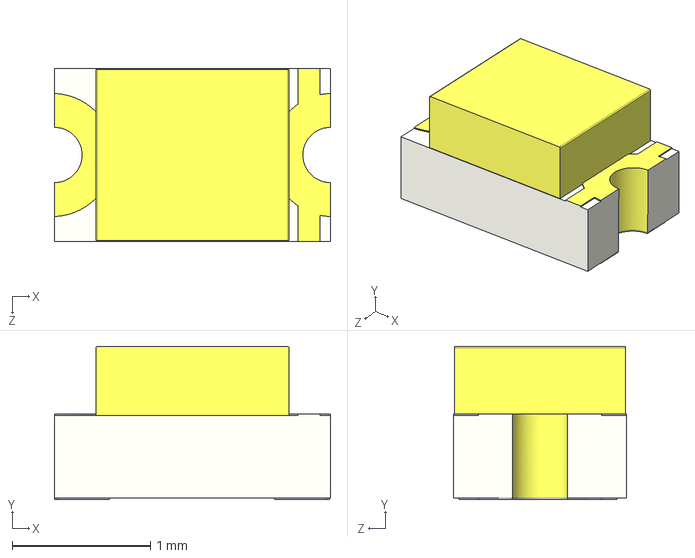
[picture p78: CAD file, 2020-04-28]
pcb设计学习/元件库/元件库/PCB3D/everlight-17-21-0805LED-YELLOW.STEP
2.00 x 1.11 x 1.25 mm
