chuangye-gu/graduation_project/pcb设计学习/元件库/元件库/PCB3D/User Library-BST-BMP180.STEP

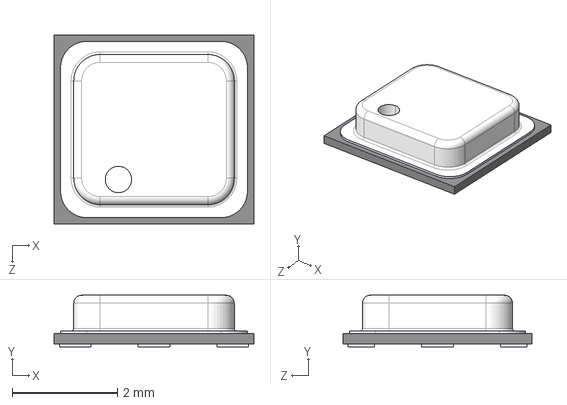
[picture p79: CAD file, 2020-04-28]
pcb设计学习/元件库/元件库/PCB3D/User Library-BST-BMP180.STEP
3.80 x 0.98 x 3.60 mm
