chuangye-gu/graduation_project/pcb设计学习/元件库/元件库/PCB3D/User Library-BH1750FVI-1.STEP

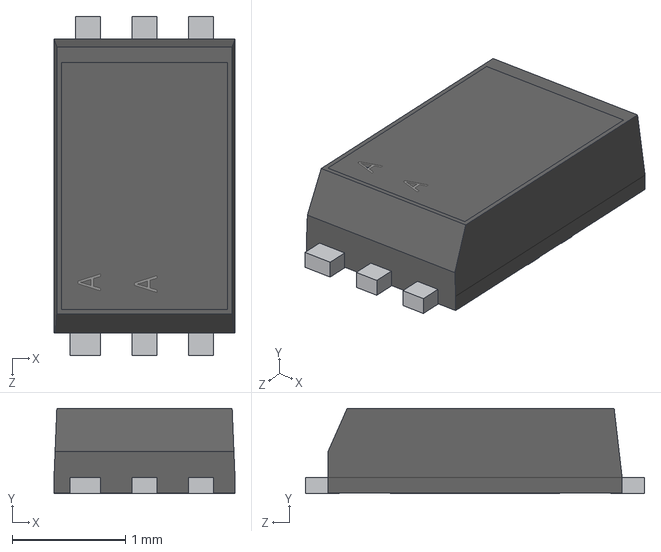
[picture p80: CAD file, 2020-04-28]
pcb设计学习/元件库/元件库/PCB3D/User Library-BH1750FVI-1.STEP
1.60 x 0.755 x 3.00 mm
