chuangye-gu/graduation_project/pcb设计学习/元件库/元件库/PCB3D/User Library-usb-AB-5P8.STEP

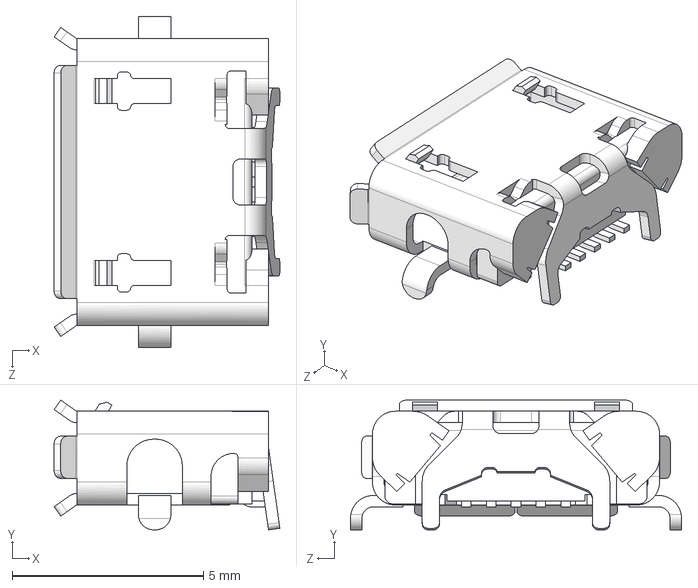
[picture p81: CAD file, 2020-04-28]
pcb设计学习/元件库/元件库/PCB3D/User Library-usb-AB-5P8.STEP
5.90 x 3.39 x 8.65 mm
