chuangye-gu/graduation_project/pcb设计学习/元件库/元件库/PCB3D/User Library-DC-05.STEP

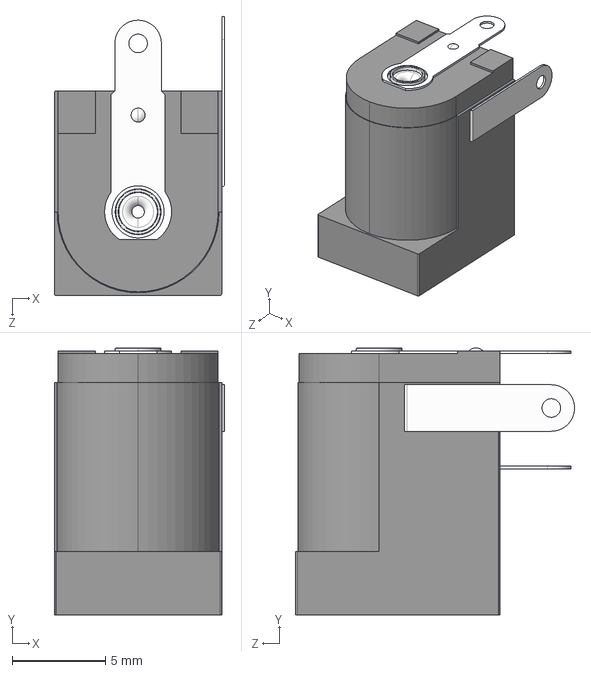
[picture p82: CAD file, 2020-04-28]
pcb设计学习/元件库/元件库/PCB3D/User Library-DC-05.STEP
9.15 x 14.3 x 15.0 mm
