chuangye-gu/graduation_project/pcb设计学习/元件库/元件库/PCB3D/User Library-32_768K.STEP

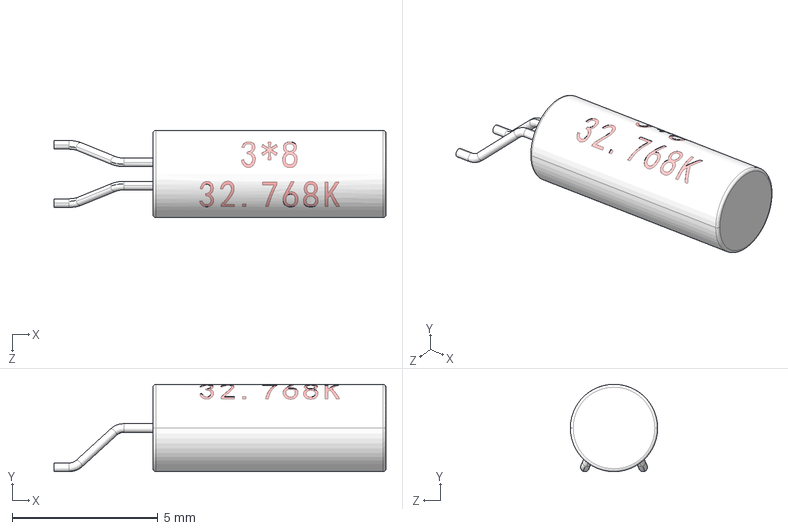
[picture p83: CAD file, 2020-04-28]
pcb设计学习/元件库/元件库/PCB3D/User Library-32_768K.STEP
11.4 x 3.00 x 3.00 mm
