chuangye-gu/graduation_project/pcb设计学习/元件库/元件库/PCB3D/beep.STEP

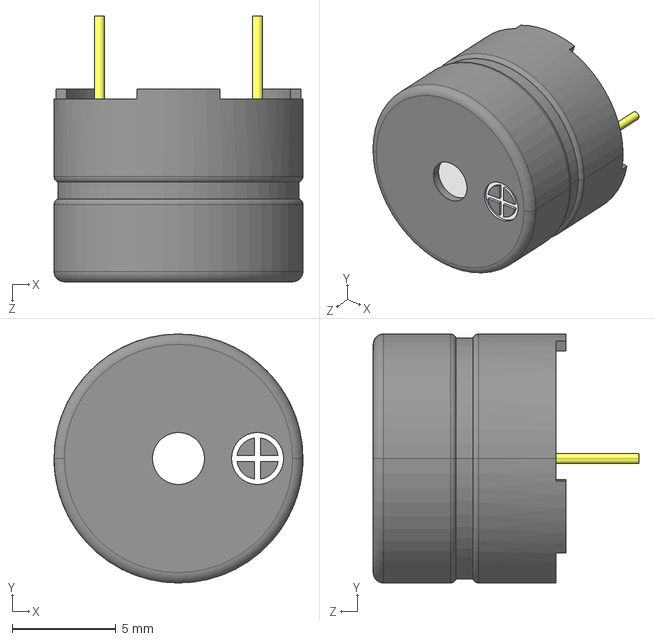
[picture p84: CAD file, 2020-04-28]
pcb设计学习/元件库/元件库/PCB3D/beep.STEP
12.0 x 12.0 x 12.8 mm
