chuangye-gu/graduation_project/pcb设计学习/元件库/元件库/PCB3D/mill-max-800-90-016-10-001000.STEP

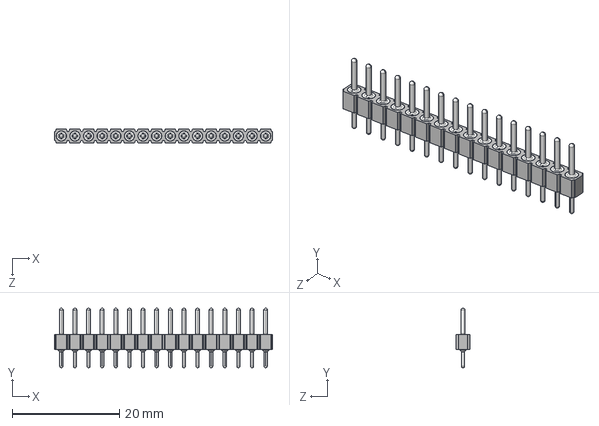
[picture p85: CAD file, 2020-04-28]
pcb设计学习/元件库/元件库/PCB3D/mill-max-800-90-016-10-001000.STEP
40.6 x 11.1 x 2.54 mm
P3XX-11-010-00-000000_P316-11-010-00-000000
