chuangye-gu/graduation_project/pcb设计学习/元件库/元件库/PCB3D/User Library-ABS07.STEP

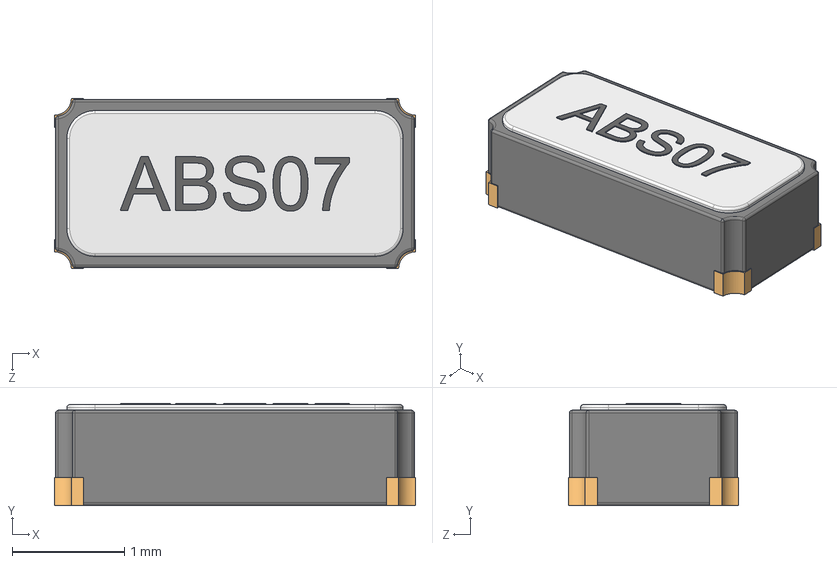
[picture p87: CAD file, 2020-04-28]
pcb设计学习/元件库/元件库/PCB3D/User Library-ABS07.STEP
3.22 x 0.91 x 1.52 mm
ABS07 Body_2
ABS07 Body2_2
ABS07 Beschriftung_2
ABS07 Pads_2
