chuangye-gu/graduation_project/pcb设计学习/元件库/元件库/PCB3D/User Library-soic16.STEP

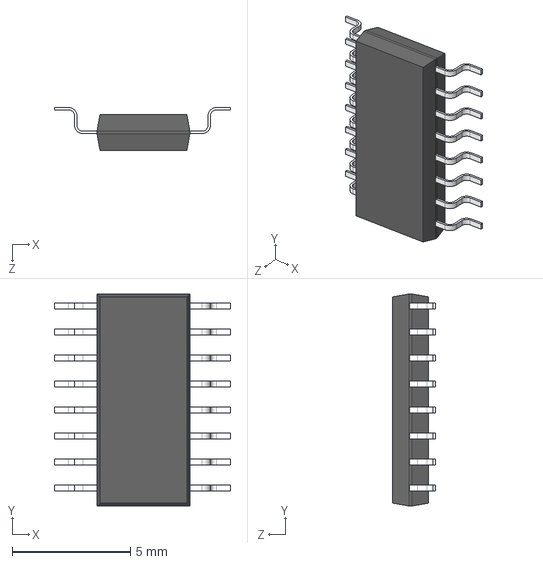
[picture p88: CAD file, 2020-04-28]
pcb设计学习/元件库/元件库/PCB3D/User Library-soic16.STEP
7.44 x 8.96 x 1.81 mm
