chuangye-gu/graduation_project/pcb设计学习/元件库/元件库/PCB3D/User Library-SHT20-1.STEP

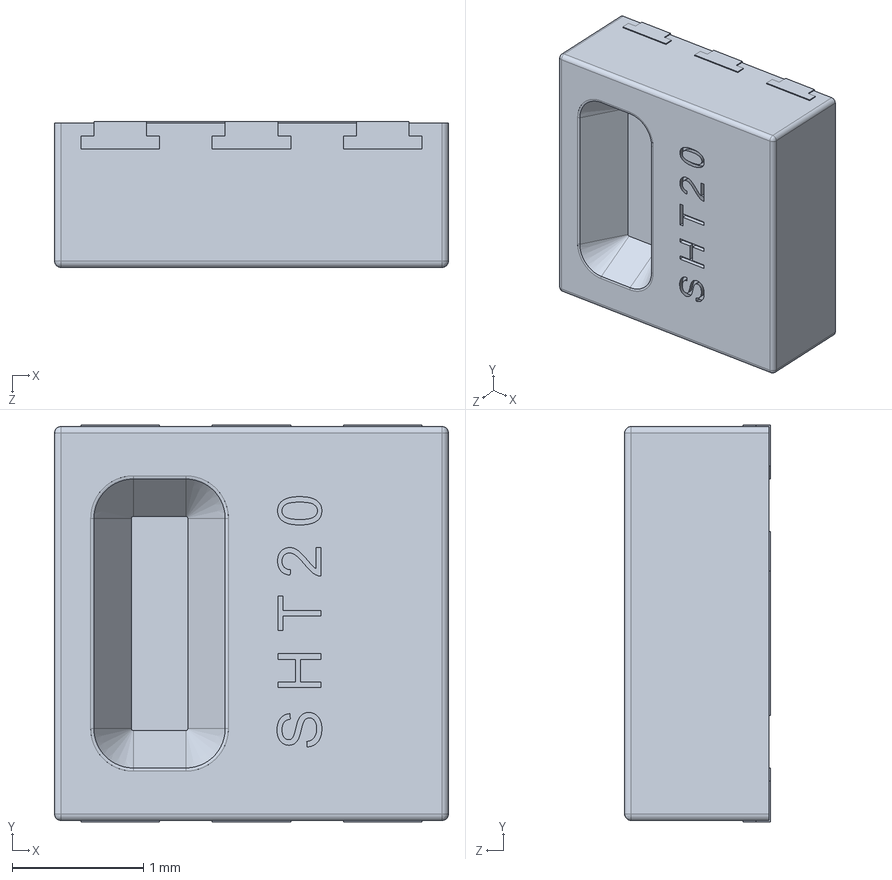
[picture p89: CAD file, 2020-04-28]
pcb设计学习/元件库/元件库/PCB3D/User Library-SHT20-1.STEP
3.00 x 3.02 x 1.11 mm
