chuangye-gu/graduation_project/pcb设计学习/元件库/元件库/PCB3D/User Library-sop16-1.STEP

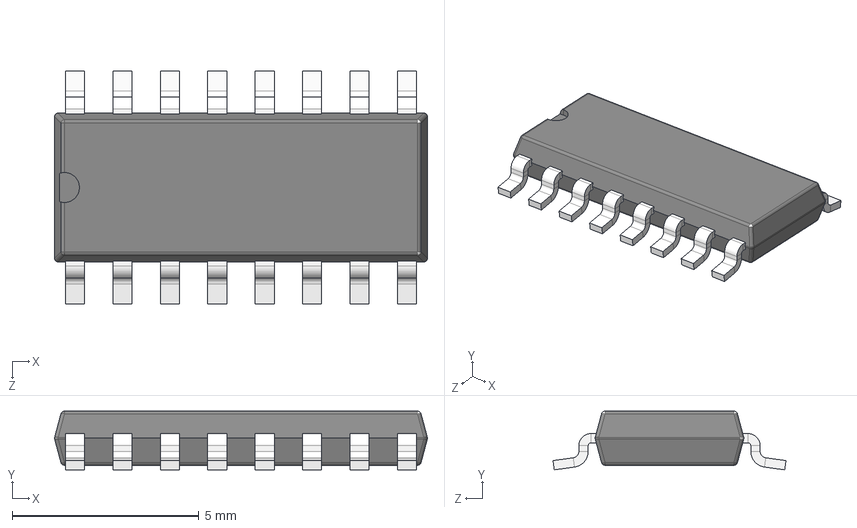
[picture p90: CAD file, 2020-04-28]
pcb设计学习/元件库/元件库/PCB3D/User Library-sop16-1.STEP
9.98 x 1.57 x 6.23 mm
