chuangye-gu/graduation_project/pcb设计学习/元件库/元件库/PCB3D/User Library-1N4148WS.STEP

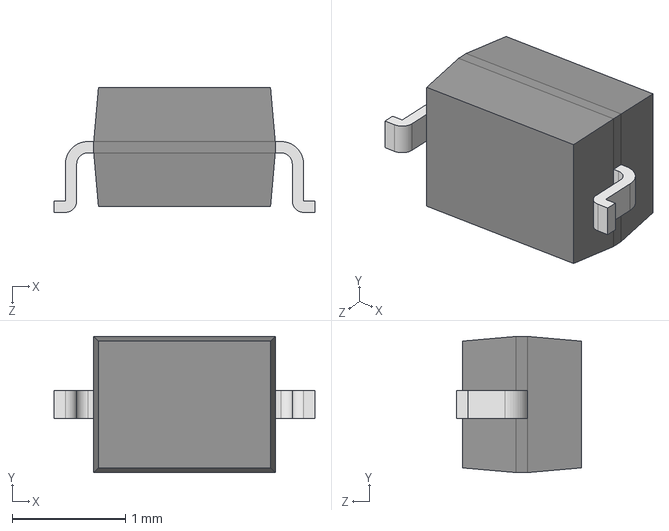
[picture p91: CAD file, 2020-04-28]
pcb设计学习/元件库/元件库/PCB3D/User Library-1N4148WS.STEP
2.30 x 1.20 x 1.10 mm
