chuangye-gu/graduation_project/pcb设计学习/元件库/元件库/PCB3D/User Library-IPEX.STEP

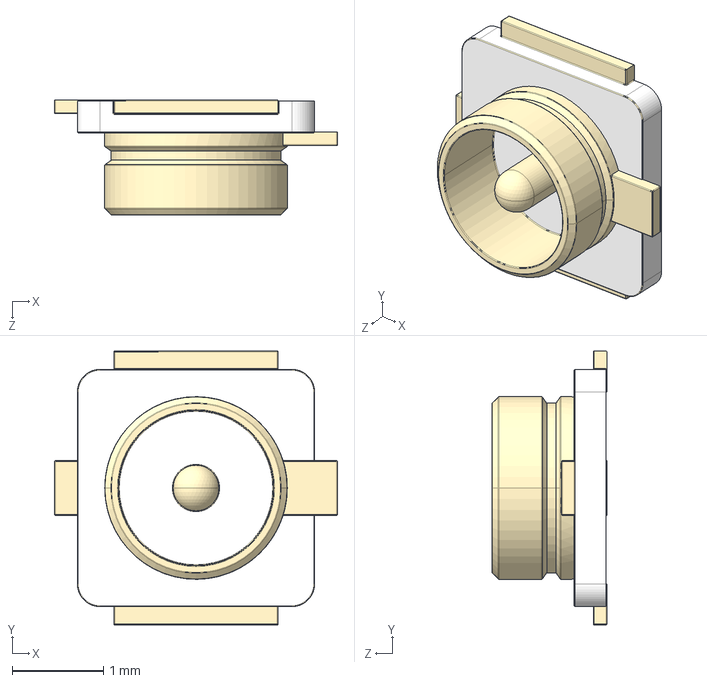
[picture p92: CAD file, 2020-04-28]
pcb设计学习/元件库/元件库/PCB3D/User Library-IPEX.STEP
3.10 x 3.00 x 1.26 mm
