chuangye-gu/graduation_project/pcb设计学习/元件库/元件库/PCB3D/User Library-usb.STEP

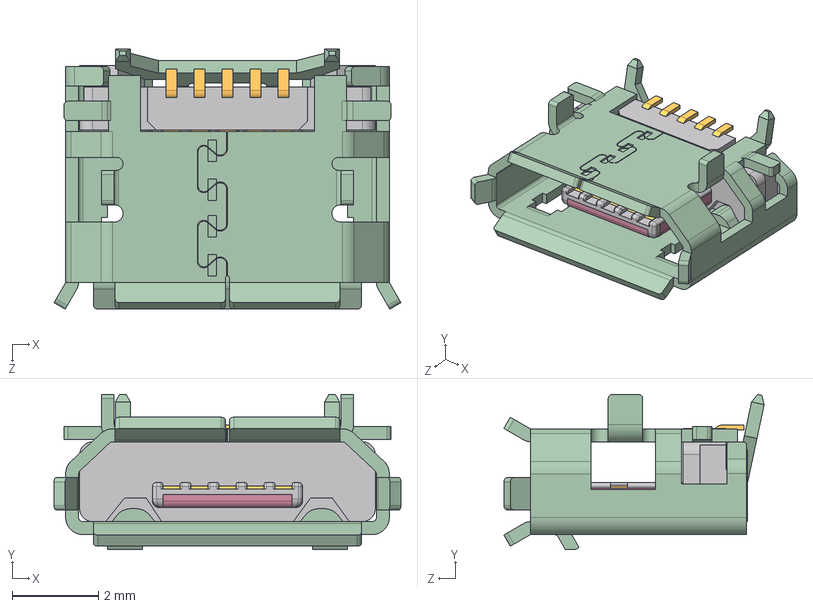
[picture p93: CAD file, 2020-04-28]
pcb设计学习/元件库/元件库/PCB3D/User Library-usb.STEP
8.04 x 3.60 x 6.03 mm
MICRO-USB-SCOKET-HOUSING
MICRO-USB-SCOKET-INSERT-TML
SHIELD
SUS_PLATE
