chuangye-gu/graduation_project/pcb设计学习/元件库/元件库/PCB3D/User Library-SOIC-16-2.STEP

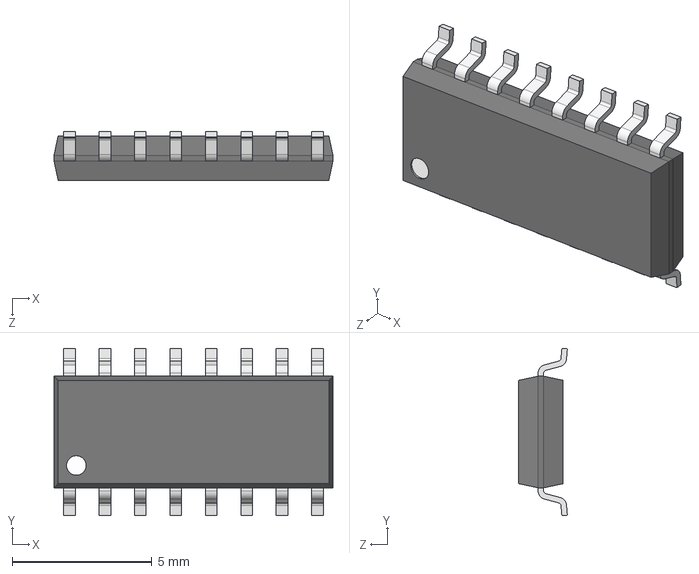
[picture p94: CAD file, 2020-04-28]
pcb设计学习/元件库/元件库/PCB3D/User Library-SOIC-16-2.STEP
10.0 x 6.00 x 1.75 mm
