chuangye-gu/graduation_project/pcb设计学习/元件库/元件库/PCB3D/User Library-TLP291-4(SOP16).STEP

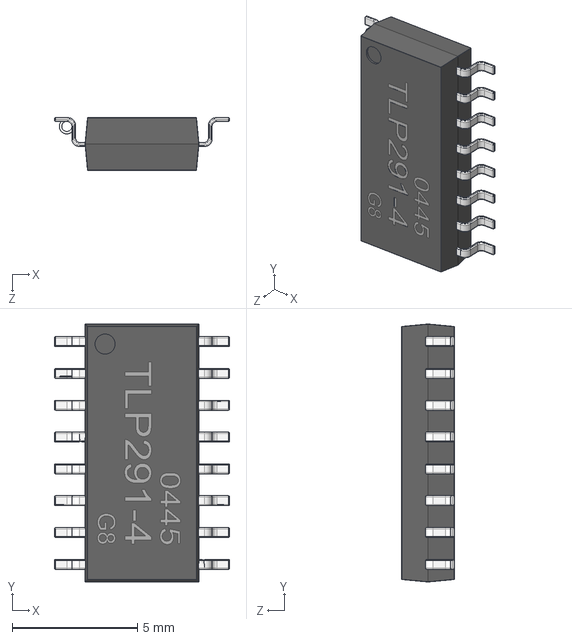
[picture p95: CAD file, 2020-04-28]
pcb设计学习/元件库/元件库/PCB3D/User Library-TLP291-4(SOP16).STEP
7.00 x 10.3 x 2.10 mm
Document
_X_EB_X_B8_X_94_X_EB_X_A1_X_9D 01
