chuangye-gu/graduation_project/pcb设计学习/元件库/元件库/PCB3D/User Library-5032_2.STEP

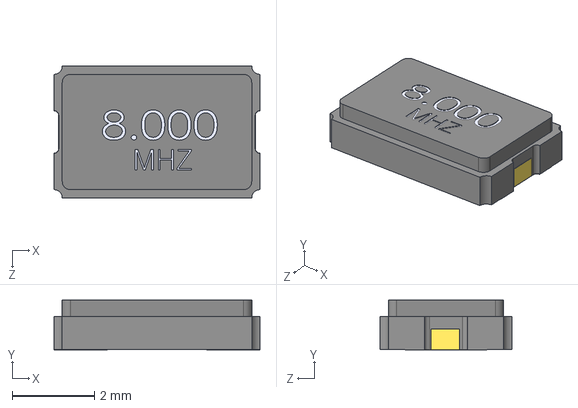
[picture p96: CAD file, 2020-04-28]
pcb设计学习/元件库/元件库/PCB3D/User Library-5032_2.STEP
5.00 x 1.21 x 3.20 mm
