chuangye-gu/graduation_project/(list of files, cad)

Other CAD files:
51/程序/STARTUP.OBJ
蔬菜大棚恒温控制/蔬菜大棚恒温控制/program/STARTUP.OBJ
蔬菜大棚恒温控制/蔬菜大棚恒温控制/程序/test.OBJ
51/程序/mian.OBJ
蔬菜大棚恒温控制/蔬菜大棚恒温控制/program/mian.obj
蔬菜大棚恒温控制/蔬菜大棚恒温控制/程序/STARTUP.OBJ
51/程序/test.OBJ
pcb设计学习/元件库/元件库/PCB3D/everlight-17-21-0805LED-red.STEP
pcb设计学习/元件库/元件库/PCB3D/everlight-17-21-0805LED-GREEN.STEP
pcb设计学习/元件库/元件库/PCB3D/everlight-17-21-0805LED-BLUE.STEP
pcb设计学习/元件库/元件库/PCB3D/16pin.x_t
pcb设计学习/元件库/元件库/PCB3D/2_3pin.x_t
pcb设计学习/元件库/元件库/PCB3D/4pin.x_t
pcb设计学习/元件库/元件库/PCB3D/User Library-soic16-1.STEP
pcb设计学习/元件库/元件库/PCB3D/hf32fv.x_t
pcb设计学习/元件库/元件库/PCB3D/terminal_blocks_a-tb500-ta02.x_t
pcb设计学习/元件库/元件库/PCB3D/usb.x_t
