chuangye-gu/graduation_project/max6675测试/1.pdf

## LCD2

# LM016L 5V

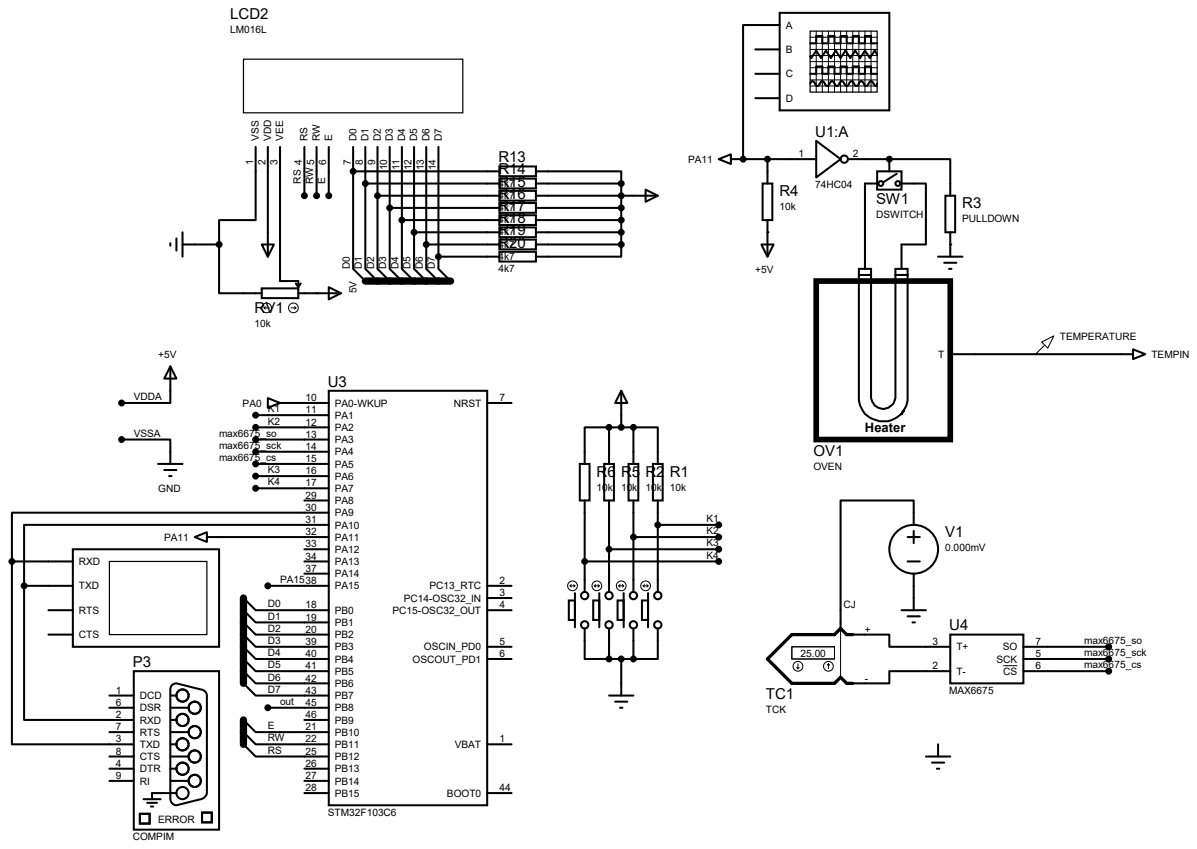
[picture p97: page 1]
