chuangye-gu/graduation_project/PCB/恒温烤箱控制系统/C329185_红头轻触开关不贴膜塑胶按钮_2018-11-06.PDF

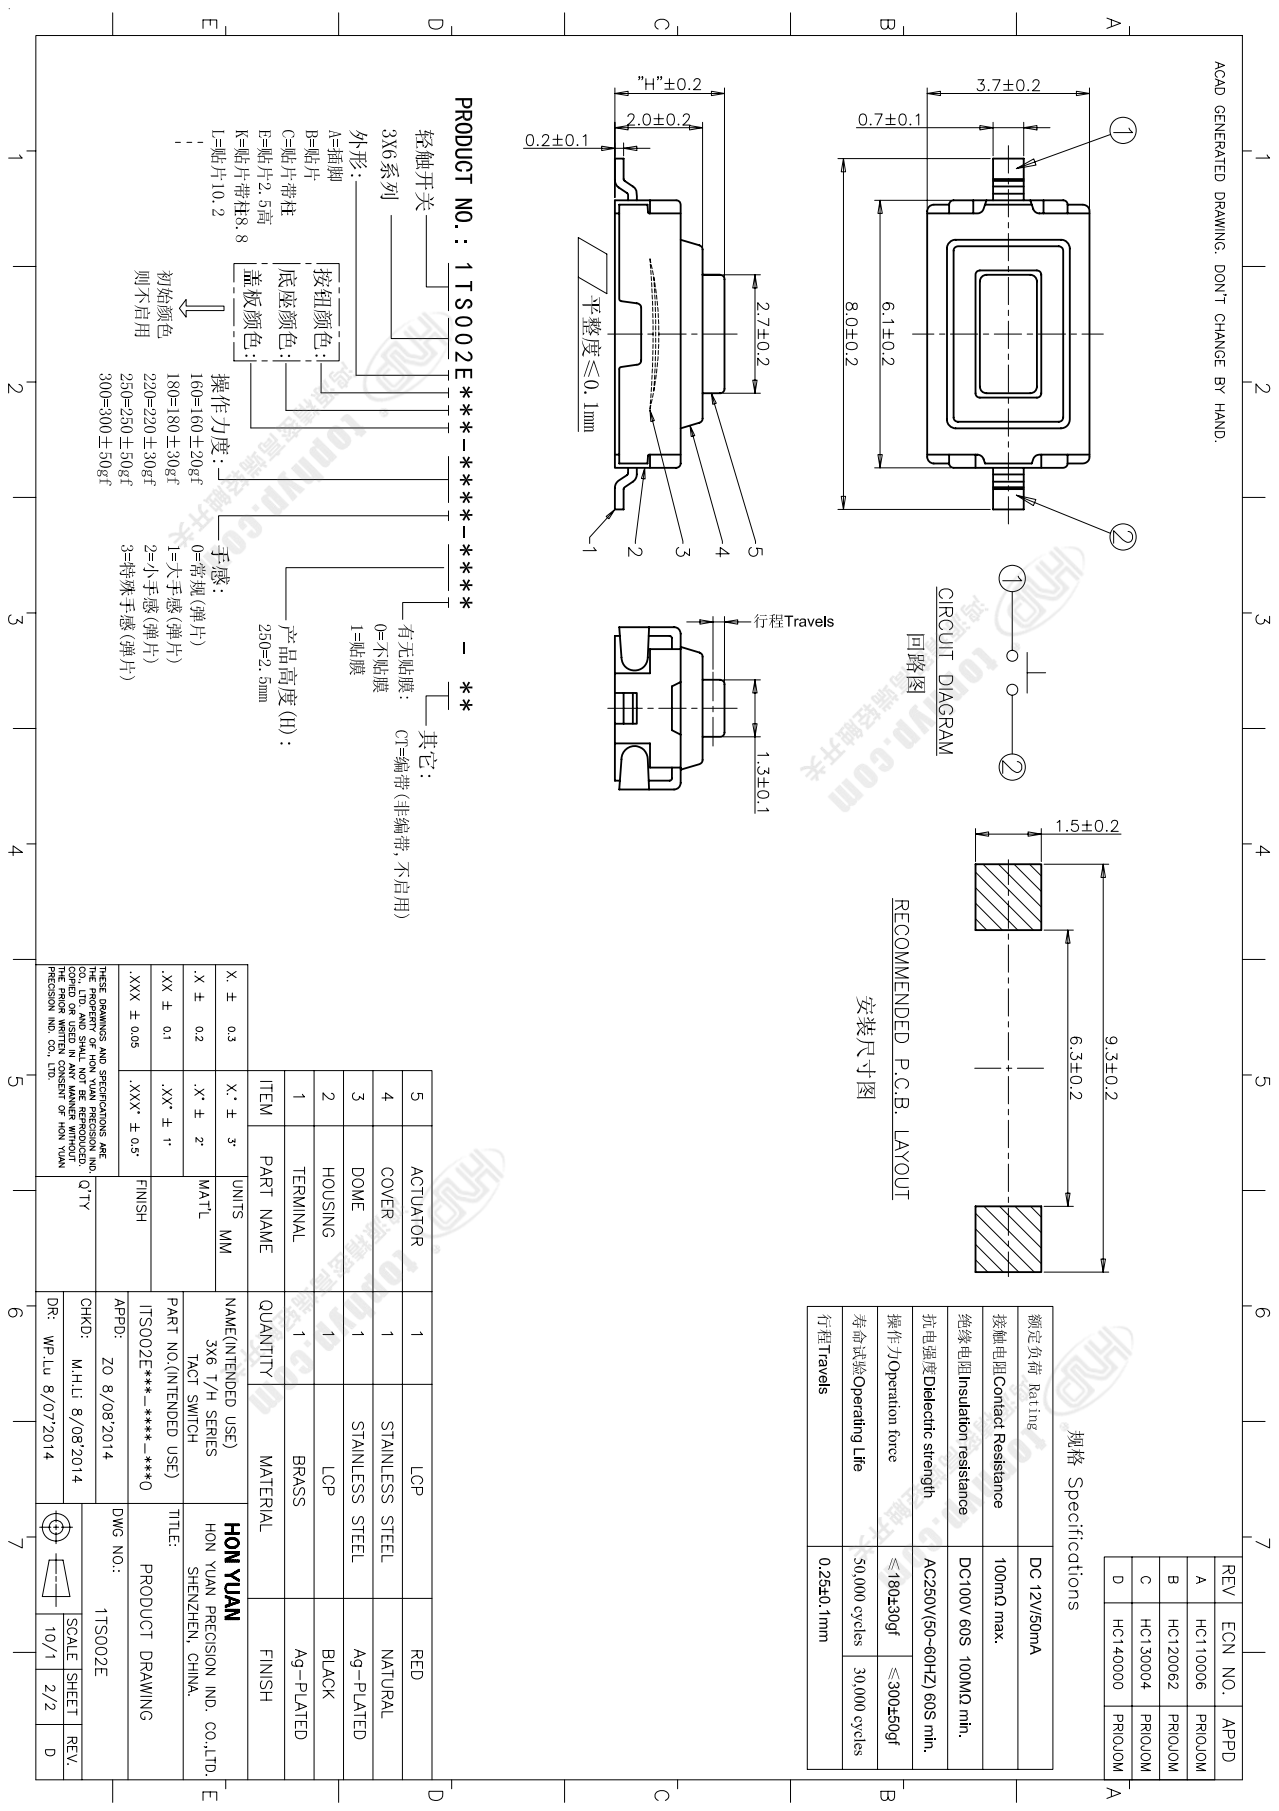
[picture p101: page 1]
