chuangye-gu/graduation_project/pcb设计学习/工程/pcb设计学习.pdf

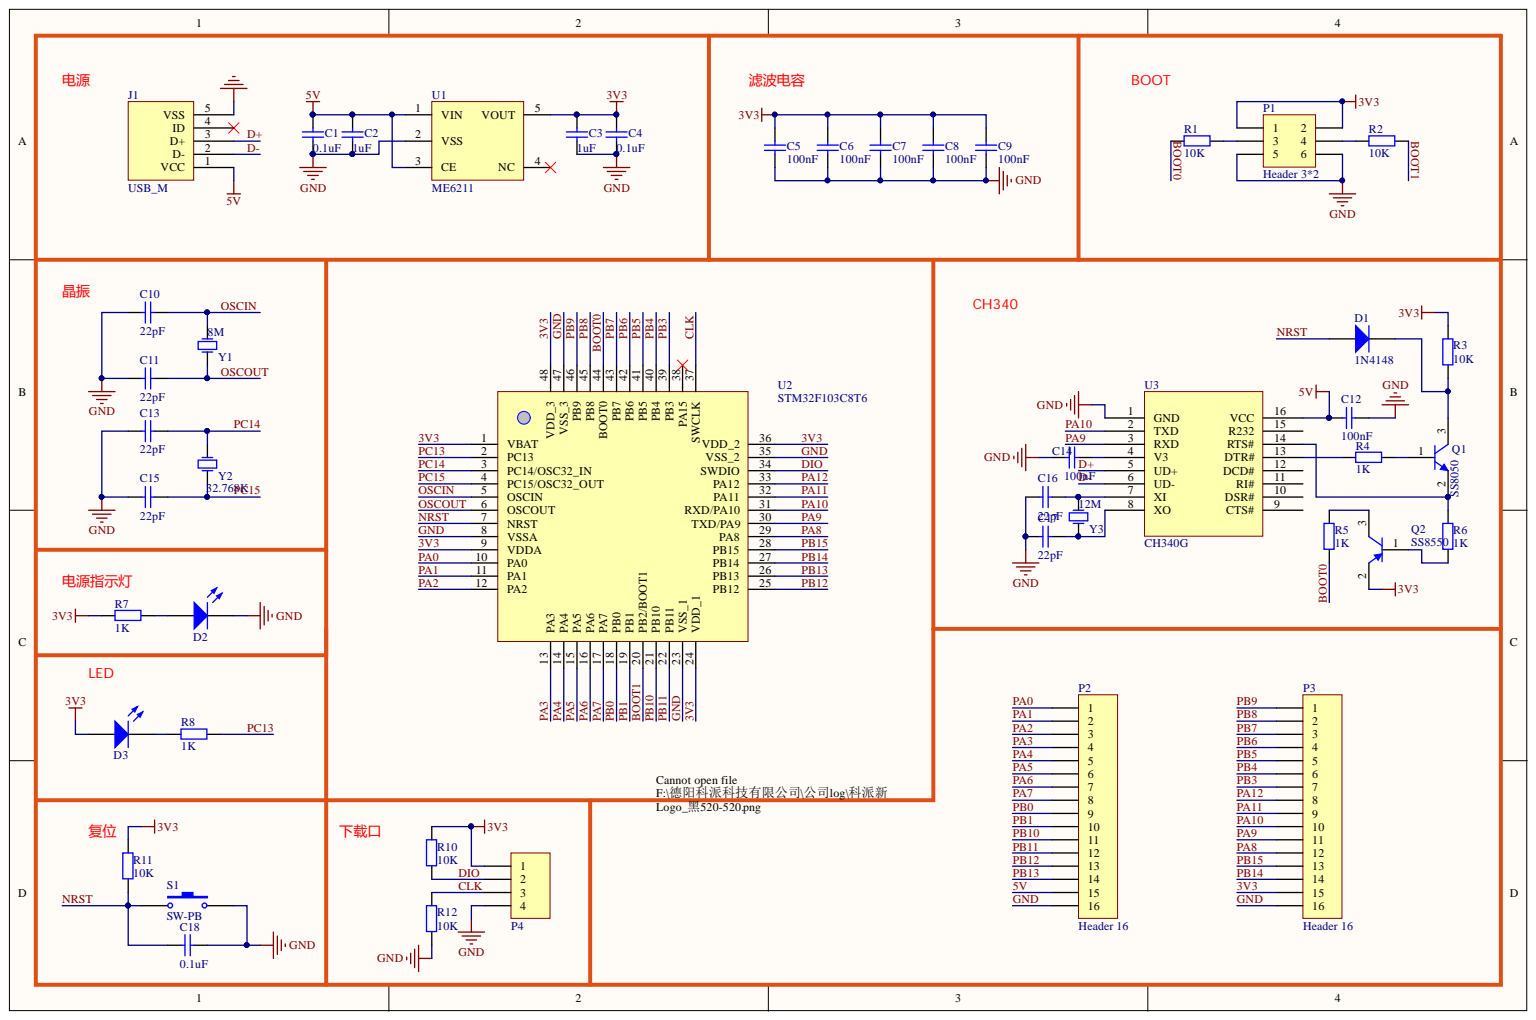
[picture p102: page 1]
