chuangye-gu/graduation_project/PCB/恒温烤箱早期/原理图.pdf

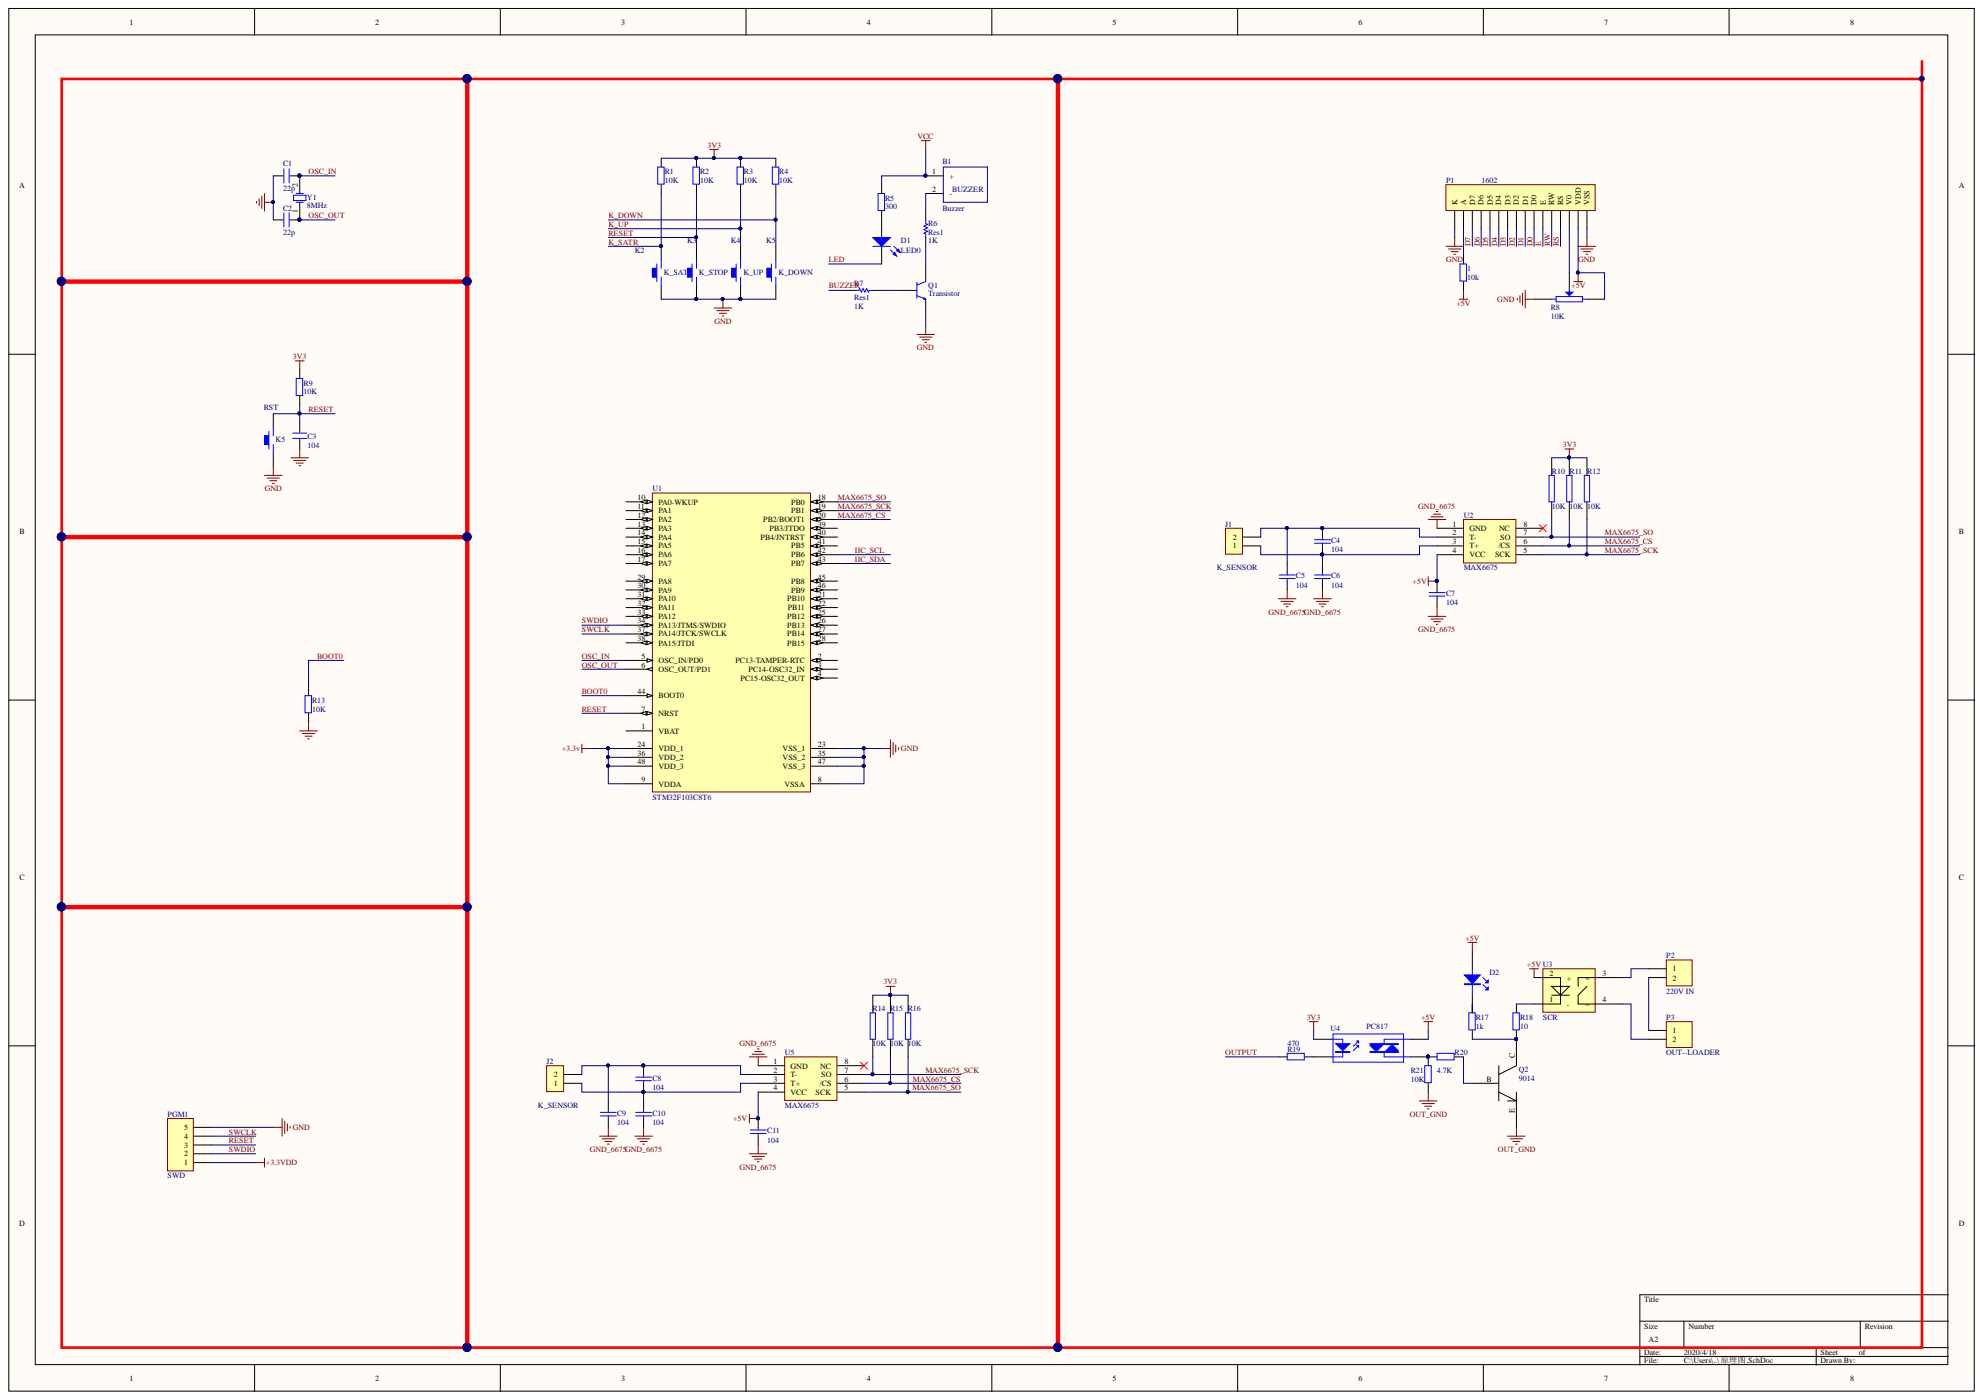
[picture p103: page 1]

K_UP
RESET
K_SATR

VDD_3 48

VDDA 9
