chuangye-gu/graduation_project/pcb设计学习/PCB_Project/PCB_Project/PCB_Project.pdf

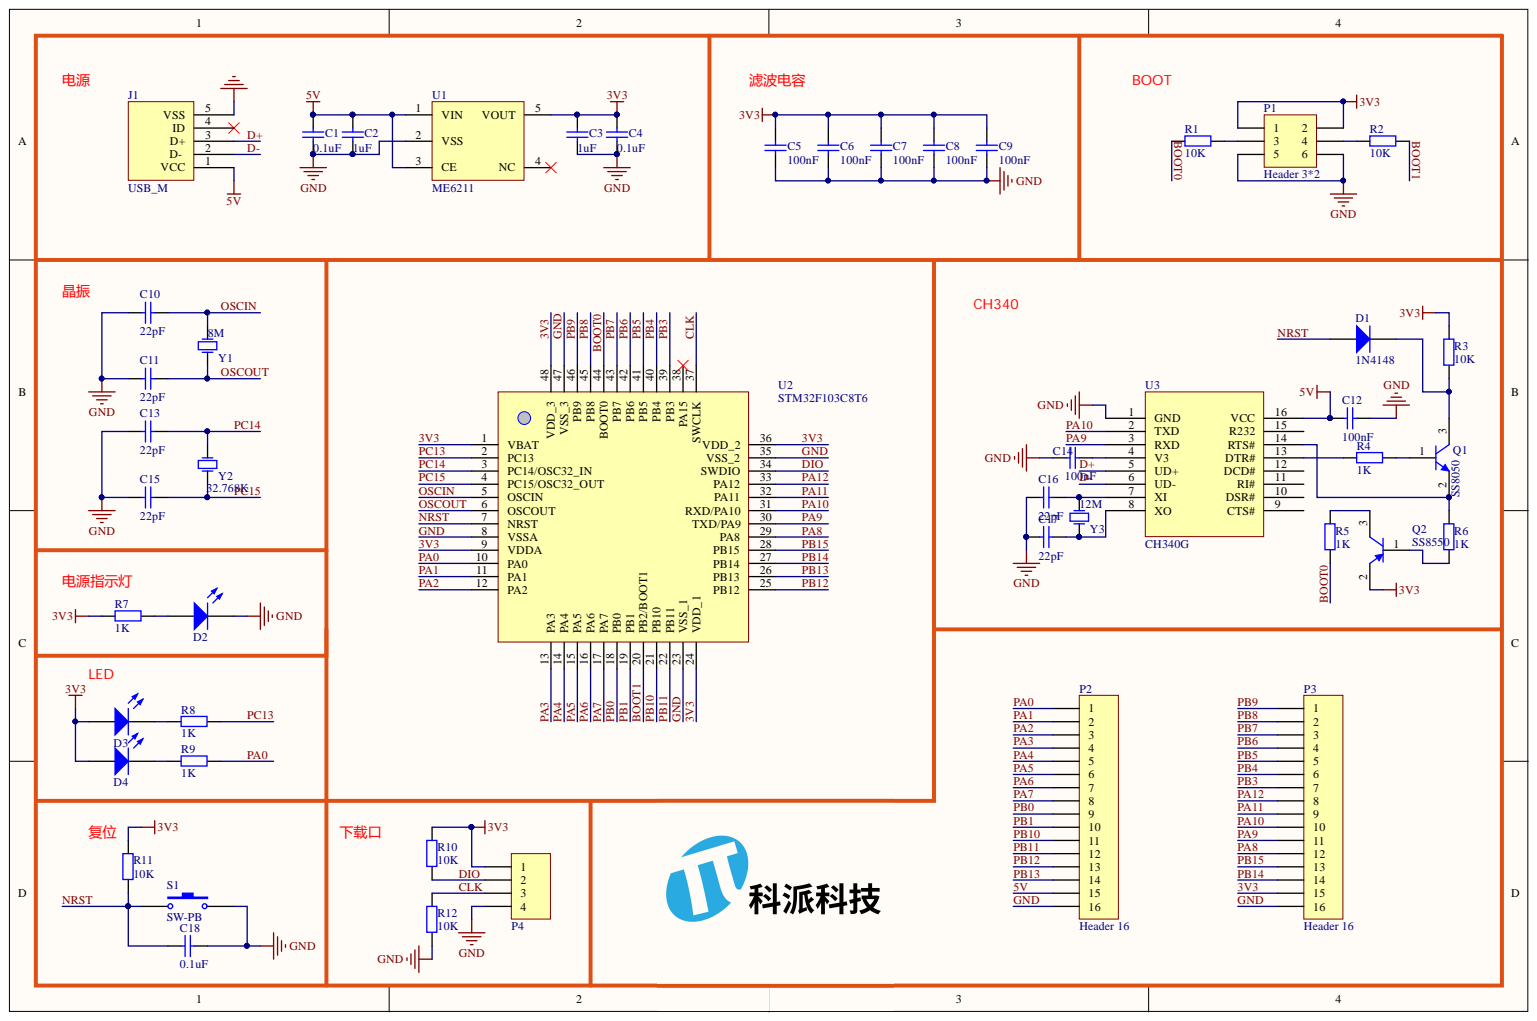
[picture p104: page 1]
