chuangye-gu/graduation_project/(list of files, drawings)

Other design files:
51/PID.pdsprj
max6675测试/恒温烤箱控制系统.pdsprj
PCB/恒温烤箱控制系统/sheet.SchDoc
PCB/恒温烤箱控制系统/恒温烤箱控制系统.PrjPCB
PCB/恒温烤箱早期/PCB.PcbDoc
PCB/恒温烤箱早期/原理图.SchDoc
PCB/恒温烤箱早期/恒温烤箱控制系统早期.PrjPCB
PCB/温控板-电路/MAX6675.SchDoc
PCB/温控板-电路/MCU.SchDoc
PCB/温控板-电路/MCU电源.SchDoc
PCB/温控板-电路/温控PCB_0617F1.PcbLib
PCB/温控板-电路/温控PCB_0617F.PcbDoc
PCB/温控板-电路/温控PCB_0617F.PcbLib
PCB/温控板-电路/温控库.PcbLib
PCB/温控板-电路/温控库.SchLib
PCB/温控板-电路/温控板.PRJPCB
PCB/温控板-电路/输出.SchDoc
pcb设计学习/PCB_Project/PCB_Project/PCB_Project.PrjPcb
pcb设计学习/PCB_Project/PCB_Project/SCH.SchDoc
pcb设计学习/元件库/元件库/AltiumDesignerIntlib-master/Analog IC/Analog IC.PcbLib
pcb设计学习/元件库/元件库/AltiumDesignerIntlib-master/Analog IC/Analog IC.SchLib
pcb设计学习/元件库/元件库/AltiumDesignerIntlib-master/Components/Components.PcbLib
pcb设计学习/元件库/元件库/AltiumDesignerIntlib-master/Components/Components.SchLib
pcb设计学习/元件库/元件库/AltiumDesignerIntlib-master/Connectors/Connectors.PcbLib
pcb设计学习/元件库/元件库/AltiumDesignerIntlib-master/Connectors/Connectors.SchLib
pcb设计学习/元件库/元件库/AltiumDesignerIntlib-master/Digital IC/Digital IC.PcbLib
pcb设计学习/元件库/元件库/AltiumDesignerIntlib-master/Digital IC/Digital IC.SchLib
pcb设计学习/元件库/元件库/AltiumDesignerIntlib-master/Microcontrollers/Microcontrollers.PcbLib
pcb设计学习/元件库/元件库/AltiumDesignerIntlib-master/Microcontrollers/Microcontrollers.SchLib
pcb设计学习/元件库/元件库/AltiumDesignerIntlib-master/Module/Module.PcbLib
pcb设计学习/元件库/元件库/AltiumDesignerIntlib-master/Module/Module.SchLib
pcb设计学习/元件库/元件库/AltumDesignerSTM32/STMicroelectronics STM32 F1/STMicroelectronics STM32 F1.PcbLib
pcb设计学习/元件库/元件库/AltumDesignerSTM32/STMicroelectronics STM32 F1/STMicroelectronics STM32 F1.SchLib
pcb设计学习/元件库/元件库/AltumDesignerSTM32/TI Amplifiers and Linear Special Function Amplifier/TI Amplifiers and Linear Special Function Amplifier.PcbLib
pcb设计学习/元件库/元件库/开关_按键原理图库.SchLib
pcb设计学习/原理图/原理图/SCH.SchDoc
pcb设计学习/工程/History/PCB.~(1).PcbDoc
pcb设计学习/工程/History/PCB.~(2).PcbDoc
pcb设计学习/工程/History/PCB.~(3).PcbDoc
pcb设计学习/工程/History/PCB.~(4).PcbDoc
pcb设计学习/工程/History/PCB.~(5).PcbDoc
pcb设计学习/工程/History/PCB.~(6).PcbDoc
pcb设计学习/工程/History/pcb设计学习.~(4).PrjPCB/pcb设计学习.~(4).PrjPCB
pcb设计学习/工程/pcb设计学习.PrjPCB
pcb设计学习/工程/原理图.SchDoc
仿真/protues仿真/恒温烤箱控制系统.pdsprj
仿真/测试/测试.pdsprj
初步完成-位置式/恒温烤箱控制系统.pdsprj
初步完成-增量式/恒温烤箱控制系统.pdsprj
蔬菜大棚恒温控制/蔬菜大棚恒温控制/Proteus/New Project.pdsprj
蔬菜大棚恒温控制/蔬菜大棚恒温控制/Proteus/改良DS18B20.pdsprj
蔬菜大棚恒温控制/蔬菜大棚恒温控制/Proteus/改良PID.pdsprj
