chuangye-gu/graduation_project/max6675测试/自己-增量式/User/pidout.h

#ifndef _pidout_
#define _pidout_

#include "stm32f10x_conf.h"

#define pwmout_1    GPIO_SetBits(GPIOA, GPIO_Pin_11)    //停止加热
#define pwmout_0    GPIO_ResetBits(GPIOA, GPIO_Pin_11)  //加热
void PIDOUT_init(void);//pid输出脚初始化
void PID_out(void); //输出PID运算结果到负载

#endif
