chuangye-gu/graduation_project/程序/STM32——LCD1602程序/User/max6675/max6675.c

#include "max6675.h"
#include "pid.h"

float temper;
extern u16 Kms10;


#define cs_1   GPIO_SetBits(GPIOB, GPIO_Pin_2)
#define cs_0   GPIO_ResetBits(GPIOB, GPIO_Pin_2)

#define sck_1  GPIO_SetBits(GPIOB, GPIO_Pin_0)
#define sck_0   GPIO_ResetBits(GPIOB, GPIO_Pin_0)

#define so GPIO_ReadInputDataBit(GPIOB,GPIO_Pin_1) 

u16 read_max6675()  //????
{
  u16 d,i; 
  //so_1;
  cs_0;
  delay_us(2);
  for(i=0;i<16;i++)
  {
    sck_1;
    delay_us(2);
    sck_0;
    delay_us(2);
    d<<=1;
    if(so)
     d++;
  }
  cs_1;
  return d;
}

void read_temper()//??????
{
  u16 d;
	if(Kms10<20)  return ;
	
  d=read_max6675();
  pid.curr=((d>>4)&0x0fff)*0.25;//????  
  Kms10=0;	
}


void Max6675_Init()
{		
	GPIO_InitTypeDef GPIO_InitStructure;
	 RCC_APB2PeriphClockCmd(RCC_APB2Periph_GPIOB,ENABLE);  //开A口时钟
// RCC_APB2PeriphClockCmd(RCC_APB2Periph_GPIOD,ENABLE);  //开D口时钟
	
	 
  GPIO_InitStructure.GPIO_Pin =GPIO_Pin_2;	
  GPIO_InitStructure.GPIO_Mode = GPIO_Mode_Out_PP;
  GPIO_InitStructure.GPIO_Speed = GPIO_Speed_50MHz;
  GPIO_Init(GPIOB, &GPIO_InitStructure);
	
	GPIO_InitStructure.GPIO_Pin =GPIO_Pin_0;	
  GPIO_InitStructure.GPIO_Mode = GPIO_Mode_IPU;
  GPIO_InitStructure.GPIO_Speed = GPIO_Speed_50MHz;
  GPIO_Init(GPIOB, &GPIO_InitStructure);
	
	
	GPIO_InitStructure.GPIO_Pin =GPIO_Pin_1;	
  GPIO_InitStructure.GPIO_Mode = GPIO_Mode_Out_PP;
  GPIO_InitStructure.GPIO_Speed = GPIO_Speed_50MHz;
  GPIO_Init(GPIOB, &GPIO_InitStructure);
}
