chuangye-gu/graduation_project/max6675测试/自己-增量式/User/max6675.c

#include "max6675.h"
#include "pid.h"

float temper;
extern u16 Kms10;


#define cs_1   GPIO_SetBits(GPIOA, GPIO_Pin_5)
#define cs_0   GPIO_ResetBits(GPIOA, GPIO_Pin_5)

#define sck_1  GPIO_SetBits(GPIOA, GPIO_Pin_4)
#define sck_0   GPIO_ResetBits(GPIOA, GPIO_Pin_4)

#define so GPIO_ReadInputDataBit(GPIOA,GPIO_Pin_3) 
void delay_us(u16 us){
	while(us--)
	{
	// for(int i=0;i<16;i++)
	//	for(int i=0;i<16;i++);
	}
}
u16 read_max6675()  //????
{
  u16 d,i; 
  //so_1;
  cs_0;
  delay_us(2);
  for(i=0;i<16;i++)
  {
    sck_1;
    delay_us(2);
    sck_0;
    delay_us(2);
    d<<=1;
    if(so)
     d++;
  }
  cs_1;
  return d;
}

void read_temper()//
{
  u16 d;
	static u16 samtim;
	samtim++;
	if(samtim<pid.T)
	  return ;
	
  d=read_max6675();
	/***************************/
  pid.Pv=((d>>4)&0x0fff)*0.25;
	/***************************/
	//pid.Pv += 25;
////	pid.Pv /= 25;
//	pid.Pv *= 25;
//	pid.Pv = d / 819.0;
//	pid.Pv /= 4;
	/***************************/
//	pid.Pv=50;
	samtim=0;	
	/*//  u16 d;
	static u16 samtim;
	samtim++;
	if(samtim<pid.T)  
		return ;
//  d=read_max6675();//读取MAX6675当前的温度值
//  pid.Pv=((d>>4)&0x0fff)*0.25;//????
	
	pid.Pv=adc_get_temp();
  samtim=0;*/
}


void Max6675_Init()
{
	GPIO_InitTypeDef GPIO_InitStructure;
	RCC_APB2PeriphClockCmd(RCC_APB2Periph_GPIOC,ENABLE);  //开A口时钟
	RCC_APB2PeriphClockCmd(RCC_APB2Periph_GPIOD,ENABLE);  //开D口时钟


	GPIO_InitStructure.GPIO_Pin =GPIO_Pin_5;	
	GPIO_InitStructure.GPIO_Mode = GPIO_Mode_Out_PP;
	GPIO_InitStructure.GPIO_Speed = GPIO_Speed_50MHz;
	GPIO_Init(GPIOA, &GPIO_InitStructure);

	GPIO_InitStructure.GPIO_Pin =GPIO_Pin_3;	
	GPIO_InitStructure.GPIO_Mode = GPIO_Mode_IPU;
	GPIO_InitStructure.GPIO_Speed = GPIO_Speed_50MHz;
	GPIO_Init(GPIOA, &GPIO_InitStructure);


	GPIO_InitStructure.GPIO_Pin =GPIO_Pin_4;	
	GPIO_InitStructure.GPIO_Mode = GPIO_Mode_Out_PP;
	GPIO_InitStructure.GPIO_Speed = GPIO_Speed_50MHz;
	GPIO_Init(GPIOA, &GPIO_InitStructure);
}
