chuangye-gu/graduation_project/max6675测试/自己-增量式/User/pwm.c

#include "stm32f10x.h"

void pwm_init(void)
{
	TIM_TimeBaseInitTypeDef  TIM_TimeBaseStructure;
	TIM_OCInitTypeDef  TIM_OCInitStructure;
	GPIO_InitTypeDef GPIO_InitStructure;
	RCC_APB2PeriphClockCmd(RCC_APB2Periph_GPIOA, ENABLE);
	RCC_APB2PeriphClockCmd(RCC_APB2Periph_TIM1, ENABLE);
	GPIO_InitStructure.GPIO_Pin =  GPIO_Pin_11;
	GPIO_InitStructure.GPIO_Mode = GPIO_Mode_AF_PP;
	GPIO_InitStructure.GPIO_Speed = GPIO_Speed_50MHz;
	GPIO_Init(GPIOA, &GPIO_InitStructure);
	//定时器配置
	TIM_DeInit(TIM1);
	/* Time base configuration */
	TIM_TimeBaseStructure.TIM_Period = 999;//1MHz / (999 + 1) = 1KHz
	TIM_TimeBaseStructure.TIM_Prescaler = 71;//1MHz主频
	TIM_TimeBaseStructure.TIM_ClockDivision = TIM_CKD_DIV1;
	TIM_TimeBaseStructure.TIM_CounterMode = TIM_CounterMode_Up;
	TIM_TimeBaseStructure.TIM_RepetitionCounter = 0;
	TIM_TimeBaseInit(TIM1, &TIM_TimeBaseStructure);
	/* PWM1 Mode configuration: Channel1 */
	/* Channel 1, 2,3 and 4 Configuration in PWM mode */
	TIM_OCInitStructure.TIM_OCMode = TIM_OCMode_PWM1;
	TIM_OCInitStructure.TIM_OutputState = TIM_OutputState_Enable;
	TIM_OCInitStructure.TIM_OutputNState = TIM_OutputNState_Disable;
	TIM_OCInitStructure.TIM_OCPolarity = TIM_OCPolarity_High;
	TIM_OCInitStructure.TIM_OCIdleState = TIM_OCIdleState_Reset;
	TIM_OCInitStructure.TIM_Pulse = 0;
	TIM_OC4Init(TIM1, &TIM_OCInitStructure);
	TIM_Cmd(TIM1, ENABLE);
	/* TIM1 Main Output Enable */
	TIM_CtrlPWMOutputs(TIM1, ENABLE);
}

void pwm_output(uint16_t pwm)
{
	TIM_SetCompare4(TIM1, pwm);
}
