chuangye-gu/graduation_project/(commit log)

2020-04-15 第一次提交
    [PCB.PcbDoc, 原理图.SchDoc, 恒温烤箱控制系统.PrjPCB, 恒温烤箱控制系统.pdsprj, 测试.pdsprj, 温度-时间.xlsx]
2020-04-20 第二次提交
    [原理图.SchDoc, 恒温烤箱控制系统.pdsprj, 温度-时间.xlsx]
2020-04-28 第三次提交
    [16pin.x_t, 2_3pin.x_t, 4pin.x_t, Analog IC.PcbLib, Analog IC.SchLib, CircuitWorks-LED 1206.STEP, CircuitWorks-SOT-23.STEP, Components.PcbLib]
2020-05-14 5.14 第一次查重
    [DXP_PCB_5446438_1.csv, DXP_PCB_5446438_1.place.csv, PID.pdsprj, STARTUP.OBJ, mian.OBJ, sheet.SchDoc, test.OBJ, 恒温烤箱控制系统.PrjPCB]
2021-03-11 修正部分文件无法打开
